schrmich/speedy_gonzales/Software/SpeedyBotV2/01 System/20180202_150233.jpg

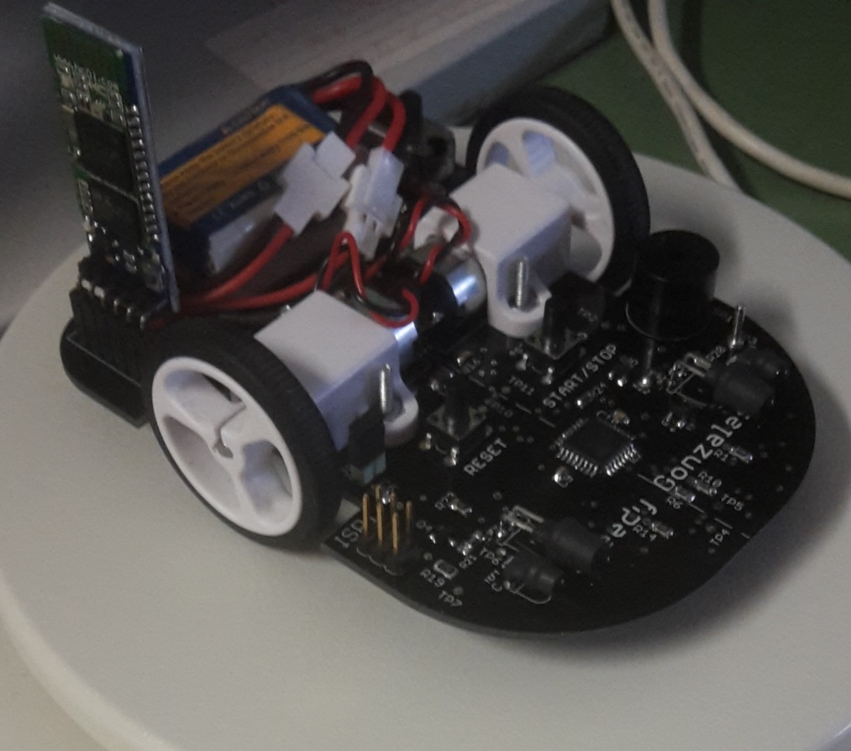
Software/SpeedyBotV2/01 System/20180202_150233.jpg
