schrmich/speedy_gonzales/Software/SpeedyBotV2/01 System/doxygen/latex/index.tex

$<$imga src=\char`\"{}/20180202\+\_\+150233.\+jpg\char`\"{} alt=\char`\"{}\+Speedy-\/bot\char`\"{}$>$

\begin{DoxyVersion}{Version}
V2 
\end{DoxyVersion}
\hypertarget{index_sec1}{}\doxysection{Einleitung}\label{index_sec1}
Der Roboter „\+Spirit bot“ ist ein kleiner frei in C programmierbarer Lern Roboter. Er soll in der Lage sein,~\newline
 verschiedene Aufgaben selbststaendig zu erledigen. Dazu gehoeren das Loesen von Linienlabyrinthen.~\newline

~\newline
\hypertarget{index_sec2_1}{}\doxysubsection{Hardware}\label{index_sec2_1}
Zur detektion von Linien ist er mit einer Reihe von 5 analogen I\+R-\/\+Reflektions Sensoren an der Unterseite ausgestattet.~\newline
 Als Antrieb dienen zwei D\+C-\/\+Getriebemotoren.~\newline
 Zwei optische Motorencoder dienen der Erfassung von zurück gelegter Entfernung.~\newline
 Zur Kommunikation wird ein H\+C-\/06 Bluetooth Modul mit 57200 Baud verwendet.~\newline
 Die Elektronik ist komplett in S\+MD aufgebaut und als Steuercomputer werkelt ein Atmega644\+PA.~\newline
\hypertarget{index_sec2_2}{}\doxysubsection{Verwendete Perepherie}\label{index_sec2_2}
\begin{DoxyAuthor}{Author}
Michael Schreiber 
\end{DoxyAuthor}
