schrmich/speedy_gonzales/Software/SpeedyBotV2/01 System/doxygen/latex/modules.tex

\doxysection{Modules}
Here is a list of all modules\+:\begin{DoxyCompactList}
\item \contentsline{section}{U\+A\+RT Library $<$uart.\+h$>$}{\pageref{group__pfleury__uart}}{}
\end{DoxyCompactList}
