schrmich/speedy_gonzales/Software/SpeedyBotV2/01 System/doxygen/latex/speedy_8h.tex

\hypertarget{speedy_8h}{}\doxysection{speedy.\+h File Reference}
\label{speedy_8h}\index{speedy.h@{speedy.h}}

Zugriff auf alle Funktionen von Speedy.  

{\ttfamily \#include \char`\"{}system.\+h\char`\"{}}\newline
{\ttfamily \#include \char`\"{}uart.\+h\char`\"{}}\newline
{\ttfamily \#include \char`\"{}timer.\+h\char`\"{}}\newline
{\ttfamily \#include \char`\"{}motor.\+h\char`\"{}}\newline
{\ttfamily \#include \char`\"{}line\+\_\+sensors.\+h\char`\"{}}\newline
{\ttfamily \#include \char`\"{}encoder.\+h\char`\"{}}\newline
{\ttfamily \#include \char`\"{}log.\+h\char`\"{}}\newline

\doxysubsection{Detailed Description}
Zugriff auf alle Funktionen von Speedy. 

Diese Datei muss uns Projekt als erstes ins Projekt includiert werden.~\newline
 In dieser Datei sind alle anderen Headerdateien der Library eingebunden.
