schrmich/speedy_gonzales/Software/SpeedyBotV2/01 System/doxygen/latex/uart_8h.tex

\hypertarget{uart_8h}{}\doxysection{uart.\+h File Reference}
\label{uart_8h}\index{uart.h@{uart.h}}
{\ttfamily \#include $<$avr/pgmspace.\+h$>$}\newline
\doxysubsection*{Macros}
\begin{DoxyCompactItemize}
\item 
\#define \mbox{\hyperlink{group__pfleury__uart_ga367ff7b5de225ed936a63239ad4adb0b}{U\+A\+R\+T\+\_\+\+B\+A\+U\+D\+\_\+\+S\+E\+L\+E\+CT}}(baud\+Rate,  xtal\+Cpu)~(((xtal\+Cpu) + 8UL $\ast$ (baud\+Rate)) / (16UL $\ast$ (baud\+Rate)) -\/1UL)
\begin{DoxyCompactList}\small\item\em U\+A\+RT Baudrate Expression. \end{DoxyCompactList}\item 
\#define \mbox{\hyperlink{group__pfleury__uart_ga1a02d45130520cb651ab313e69039382}{U\+A\+R\+T\+\_\+\+B\+A\+U\+D\+\_\+\+S\+E\+L\+E\+C\+T\+\_\+\+D\+O\+U\+B\+L\+E\+\_\+\+S\+P\+E\+ED}}(baud\+Rate,  xtal\+Cpu)~( ((((xtal\+Cpu) + 4UL $\ast$ (baud\+Rate)) / (8UL $\ast$ (baud\+Rate)) -\/1UL)) $\vert$ 0x8000)
\begin{DoxyCompactList}\small\item\em U\+A\+RT Baudrate Expression for A\+Tmega double speed mode. \end{DoxyCompactList}\item 
\#define \mbox{\hyperlink{group__pfleury__uart_ga5bdd6772c246436bb14377095de79b31}{U\+A\+R\+T\+\_\+\+R\+X\+\_\+\+B\+U\+F\+F\+E\+R\+\_\+\+S\+I\+ZE}}~32
\begin{DoxyCompactList}\small\item\em Size of the circular receive buffer, must be power of 2. \end{DoxyCompactList}\item 
\#define \mbox{\hyperlink{group__pfleury__uart_ga05f5d709605c6317c97e4974bec3402a}{U\+A\+R\+T\+\_\+\+T\+X\+\_\+\+B\+U\+F\+F\+E\+R\+\_\+\+S\+I\+ZE}}~32
\begin{DoxyCompactList}\small\item\em Size of the circular transmit buffer, must be power of 2. \end{DoxyCompactList}\item 
\#define \mbox{\hyperlink{group__pfleury__uart_gabcdb1041d763560cd8f8e722370dfd37}{U\+A\+R\+T\+\_\+\+F\+R\+A\+M\+E\+\_\+\+E\+R\+R\+OR}}~0x1000
\begin{DoxyCompactList}\small\item\em Framing Error by U\+A\+RT ~\newline
 \end{DoxyCompactList}\item 
\#define \mbox{\hyperlink{group__pfleury__uart_ga3183177e3613d8785d8cc8516931beb6}{U\+A\+R\+T\+\_\+\+O\+V\+E\+R\+R\+U\+N\+\_\+\+E\+R\+R\+OR}}~0x0800
\begin{DoxyCompactList}\small\item\em Overrun condition by U\+A\+RT ~\newline
 \end{DoxyCompactList}\item 
\#define \mbox{\hyperlink{group__pfleury__uart_ga946e3d317937e003d2057bf19e96dd1d}{U\+A\+R\+T\+\_\+\+P\+A\+R\+I\+T\+Y\+\_\+\+E\+R\+R\+OR}}~0x0400
\begin{DoxyCompactList}\small\item\em Parity Error by U\+A\+RT ~\newline
 \end{DoxyCompactList}\item 
\#define \mbox{\hyperlink{group__pfleury__uart_ga94758f3dad6864703b7417d3e40f11df}{U\+A\+R\+T\+\_\+\+B\+U\+F\+F\+E\+R\+\_\+\+O\+V\+E\+R\+F\+L\+OW}}~0x0200
\begin{DoxyCompactList}\small\item\em receive ringbuffer overflow \end{DoxyCompactList}\item 
\#define \mbox{\hyperlink{group__pfleury__uart_ga77ba544d423ff42d400220a05303f268}{U\+A\+R\+T\+\_\+\+N\+O\+\_\+\+D\+A\+TA}}~0x0100
\begin{DoxyCompactList}\small\item\em no receive data available ~\newline
 \end{DoxyCompactList}\item 
\#define \mbox{\hyperlink{group__pfleury__uart_gae9e143569df2285379bc55f9f5595bf9}{uart\+\_\+puts\+\_\+P}}(\+\_\+\+\_\+s)~\mbox{\hyperlink{group__pfleury__uart_ga6d78b6744db6232f52b4616402036c2f}{uart\+\_\+puts\+\_\+p}}(P\+S\+TR(\+\_\+\+\_\+s))
\begin{DoxyCompactList}\small\item\em Macro to automatically put a string constant into program memory. \end{DoxyCompactList}\item 
\#define \mbox{\hyperlink{group__pfleury__uart_gaabd7a5b0c15611ee9ecb2873cc9ee87a}{uart1\+\_\+puts\+\_\+P}}(\+\_\+\+\_\+s)~\mbox{\hyperlink{group__pfleury__uart_ga1e8074d0a2d5922601c5db2f9777ba79}{uart1\+\_\+puts\+\_\+p}}(P\+S\+TR(\+\_\+\+\_\+s))
\begin{DoxyCompactList}\small\item\em Macro to automatically put a string constant into program memory. \end{DoxyCompactList}\end{DoxyCompactItemize}
\doxysubsection*{Functions}
\begin{DoxyCompactItemize}
\item 
void \mbox{\hyperlink{group__pfleury__uart_gac19a76bb7d446125734a67f9f4b68991}{uart\+\_\+init}} (unsigned int baudrate)
\begin{DoxyCompactList}\small\item\em Initialize U\+A\+RT and set baudrate. \end{DoxyCompactList}\item 
unsigned int \mbox{\hyperlink{group__pfleury__uart_gaefaab30a8338ec46a6be35b99b1b4f09}{uart\+\_\+getc}} (void)
\begin{DoxyCompactList}\small\item\em Get received byte from ringbuffer. \end{DoxyCompactList}\item 
void \mbox{\hyperlink{group__pfleury__uart_gad975221bc08b901e4c7ad69f9c9a97e2}{uart\+\_\+putc}} (unsigned char data)
\begin{DoxyCompactList}\small\item\em Put byte to ringbuffer for transmitting via U\+A\+RT. \end{DoxyCompactList}\item 
void \mbox{\hyperlink{group__pfleury__uart_gae52facc0a56086a365bb0018160d8d71}{uart\+\_\+puts}} (const char $\ast$s)
\begin{DoxyCompactList}\small\item\em Put string to ringbuffer for transmitting via U\+A\+RT. \end{DoxyCompactList}\item 
void \mbox{\hyperlink{group__pfleury__uart_ga6d78b6744db6232f52b4616402036c2f}{uart\+\_\+puts\+\_\+p}} (const char $\ast$s)
\begin{DoxyCompactList}\small\item\em Put string from program memory to ringbuffer for transmitting via U\+A\+RT. \end{DoxyCompactList}\item 
void \mbox{\hyperlink{group__pfleury__uart_ga4db697cb5469fd70e794fa7df73a6d6a}{uart1\+\_\+init}} (unsigned int baudrate)
\begin{DoxyCompactList}\small\item\em Initialize U\+S\+A\+R\+T1 (only available on selected A\+Tmegas) \end{DoxyCompactList}\item 
unsigned int \mbox{\hyperlink{group__pfleury__uart_gaeb1405c641e5bc9b7224018f5e8d90de}{uart1\+\_\+getc}} (void)
\begin{DoxyCompactList}\small\item\em Get received byte of U\+S\+A\+R\+T1 from ringbuffer. (only available on selected A\+Tmega) \end{DoxyCompactList}\item 
void \mbox{\hyperlink{group__pfleury__uart_gab465f689d197fadfbacc374fc9411154}{uart1\+\_\+putc}} (unsigned char data)
\begin{DoxyCompactList}\small\item\em Put byte to ringbuffer for transmitting via U\+S\+A\+R\+T1 (only available on selected A\+Tmega) \end{DoxyCompactList}\item 
void \mbox{\hyperlink{group__pfleury__uart_ga5568f8f3913b218fd4d0346af78831b2}{uart1\+\_\+puts}} (const char $\ast$s)
\begin{DoxyCompactList}\small\item\em Put string to ringbuffer for transmitting via U\+S\+A\+R\+T1 (only available on selected A\+Tmega) \end{DoxyCompactList}\item 
void \mbox{\hyperlink{group__pfleury__uart_ga1e8074d0a2d5922601c5db2f9777ba79}{uart1\+\_\+puts\+\_\+p}} (const char $\ast$s)
\begin{DoxyCompactList}\small\item\em Put string from program memory to ringbuffer for transmitting via U\+S\+A\+R\+T1 (only available on selected A\+Tmega) \end{DoxyCompactList}\end{DoxyCompactItemize}
