schrmich/speedy_gonzales/Doku/Rechnung JLCPCB 15.04.2020.pdf

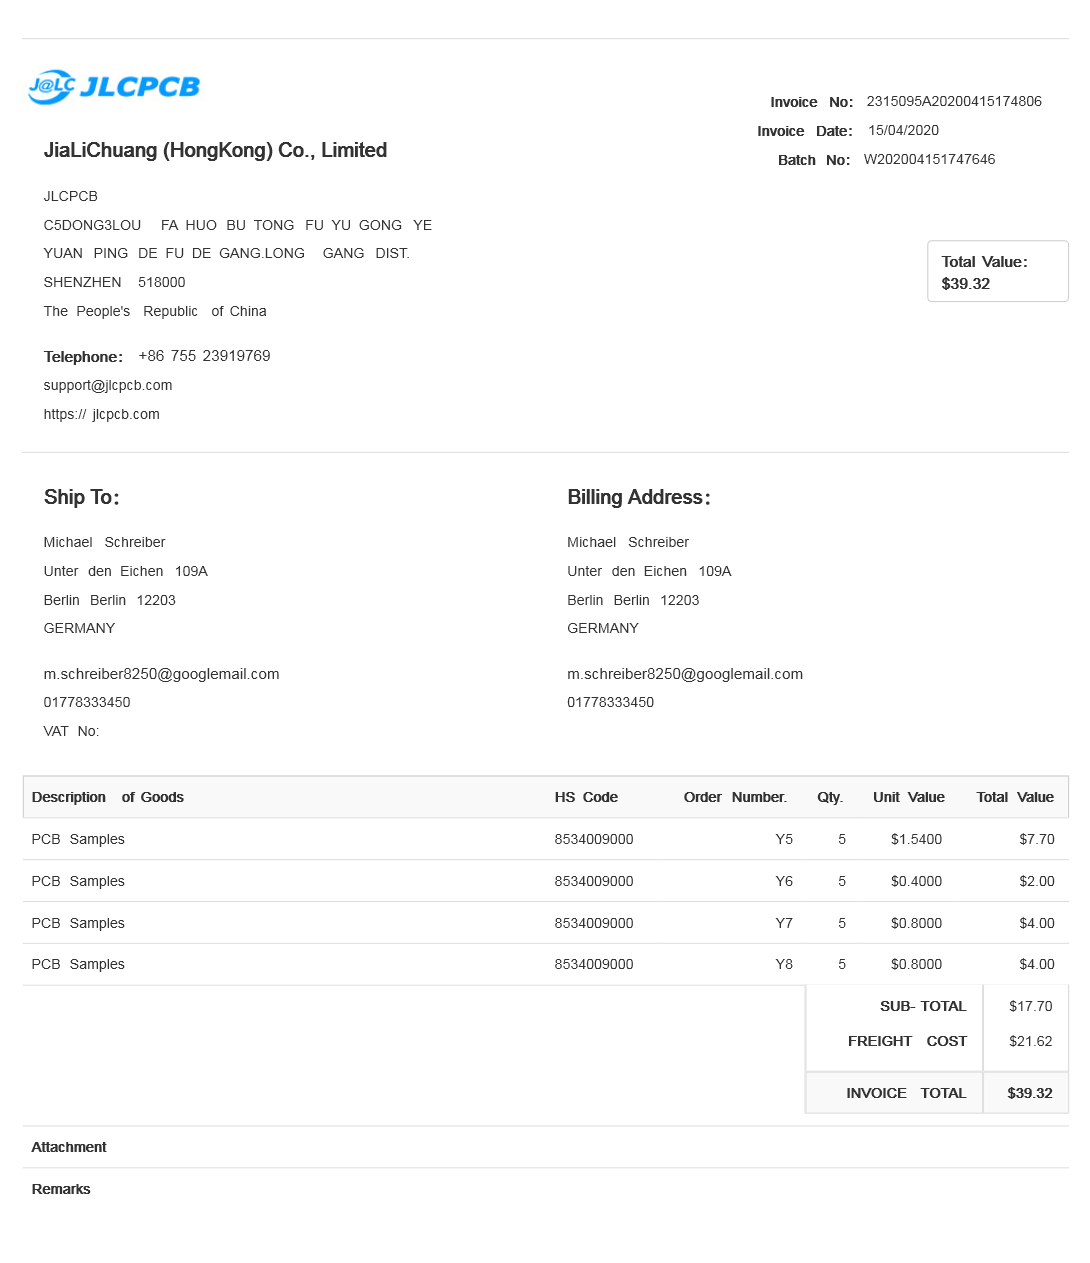
[picture p2: page 1]
