schrmich/speedy_gonzales/Doku/ascii-tabelle.gif

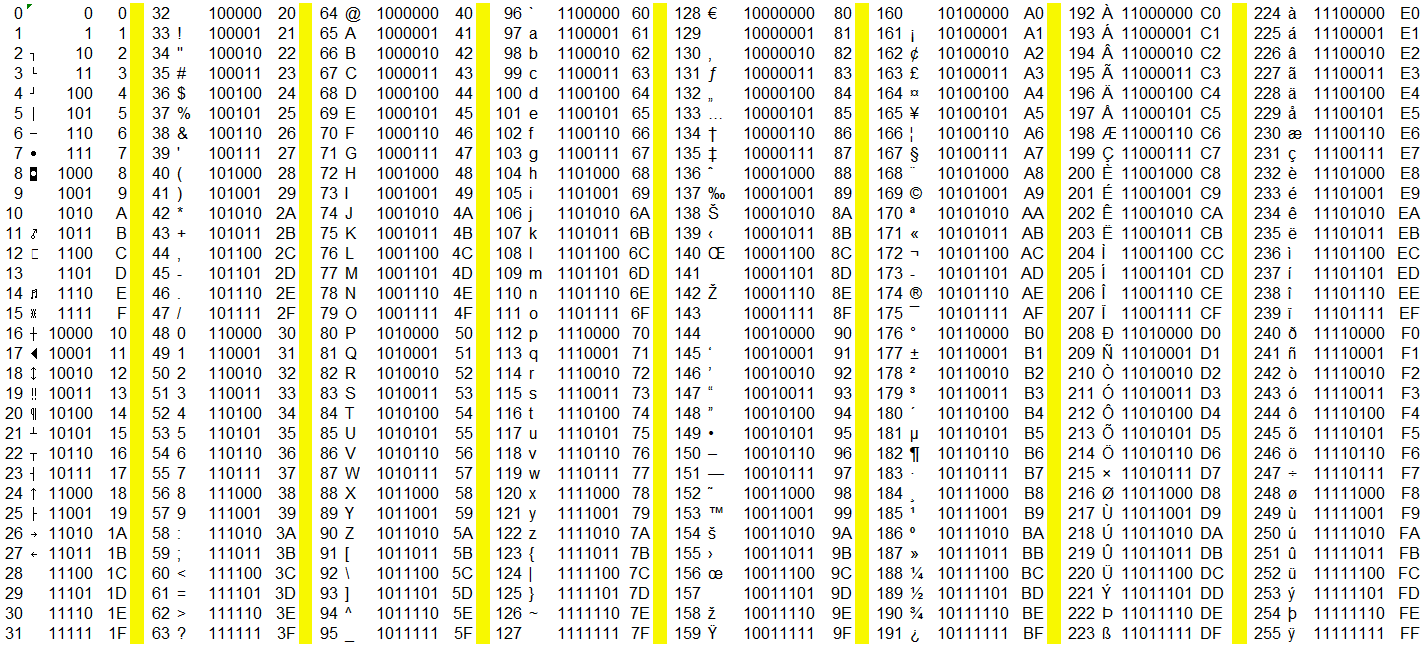
Doku/ascii-tabelle.gif
