schrmich/speedy_gonzales/Doku/Encoder/Encoder.bmp

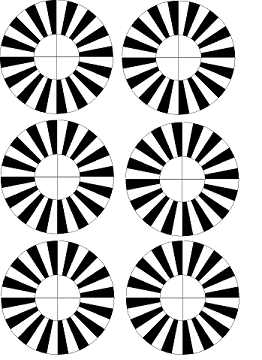
Doku/Encoder/Encoder.bmp
