schrmich/speedy_gonzales/Doku/Encoder/Encoder_slice.png

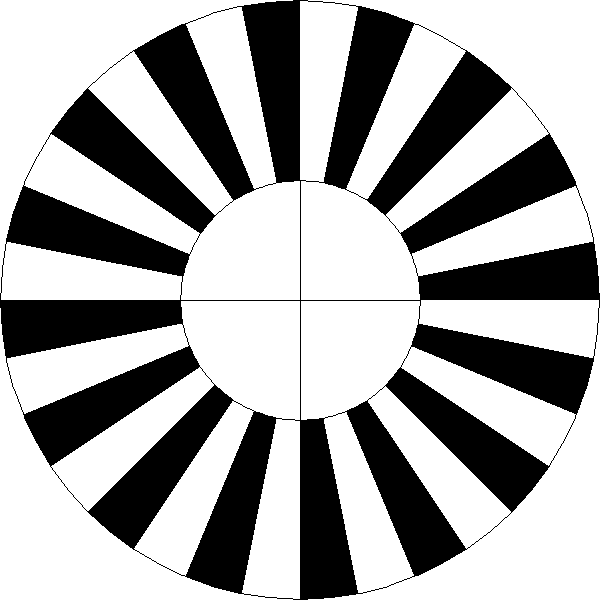
Doku/Encoder/Encoder_slice.png
