schrmich/speedy_gonzales/Doku/Encoder/SCR02.PNG

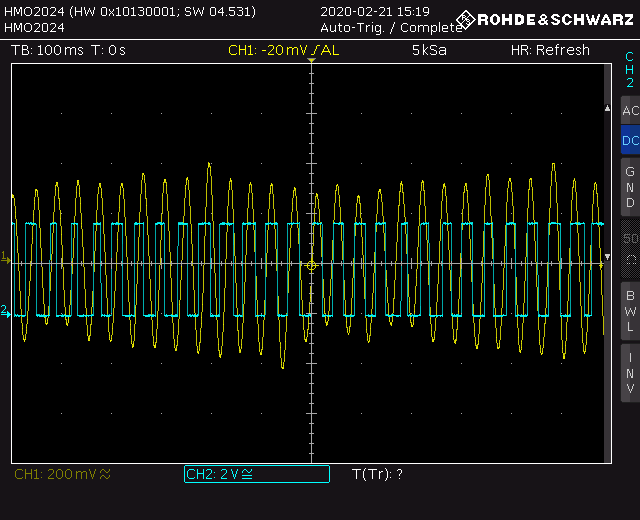
Doku/Encoder/SCR02.PNG
