schrmich/speedy_gonzales/Doku/Encoder/SCR03.PNG

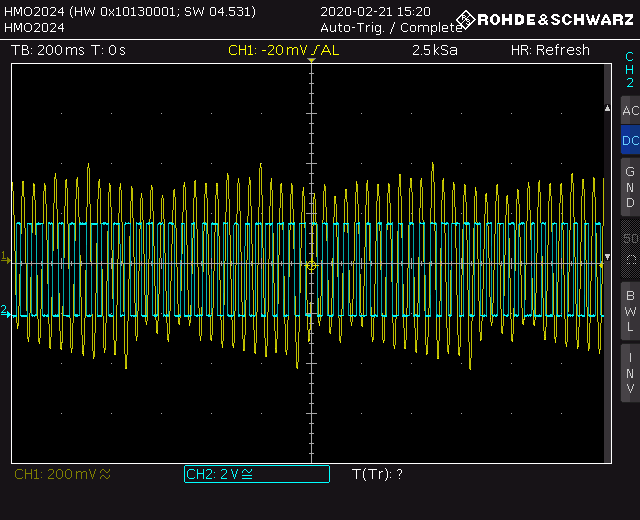
Doku/Encoder/SCR03.PNG
