schrmich/speedy_gonzales/Doku/Encoder/SCR04.PNG

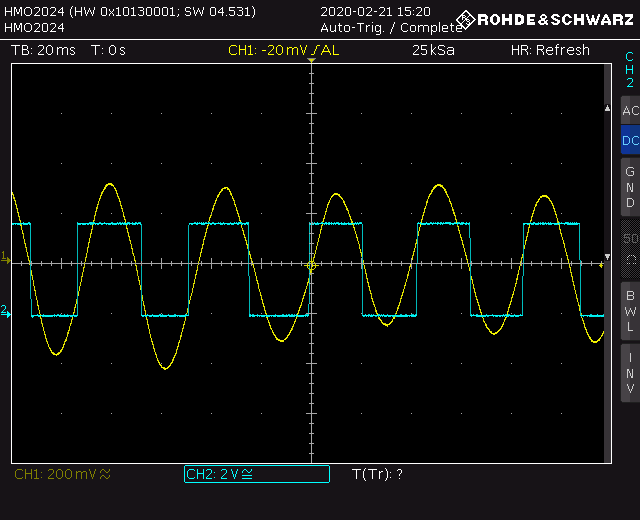
Doku/Encoder/SCR04.PNG
