schrmich/speedy_gonzales/Doku/Linien/Linienkurs#1.png

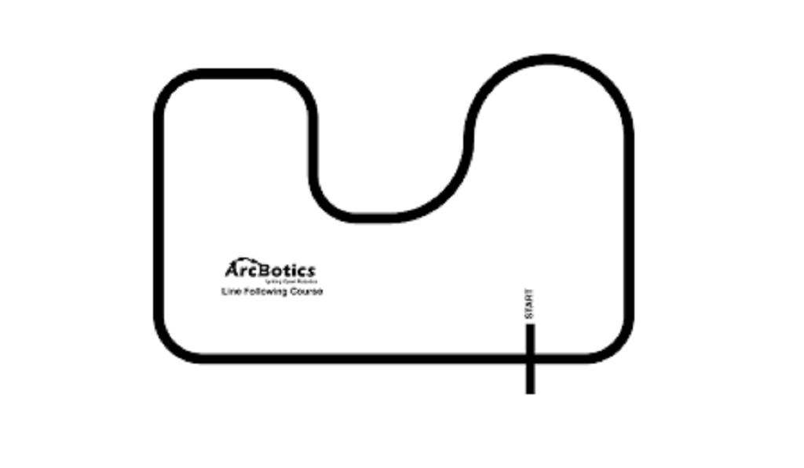
Doku/Linien/Linienkurs#1.png
