schrmich/speedy_gonzales/Doku/Maze Solver Flowcharts/Maze Search I State-Machine.png

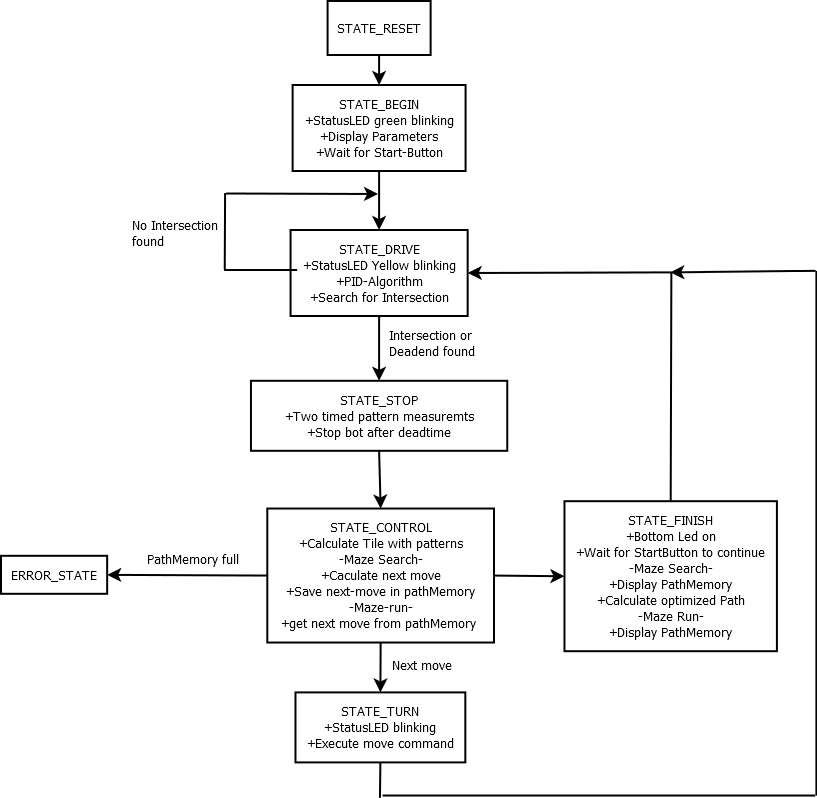
Doku/Maze Solver Flowcharts/Maze Search I State-Machine.png
