schrmich/speedy_gonzales/Doku/Maze Solver Flowcharts/Maze Search II.png

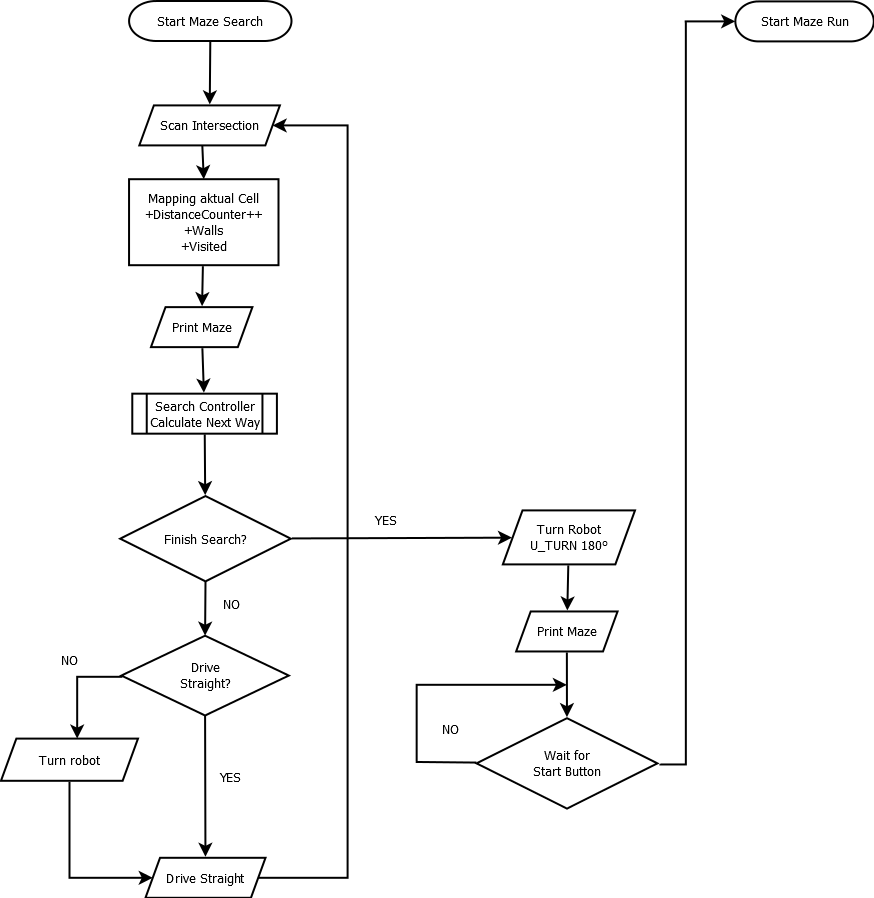
Doku/Maze Solver Flowcharts/Maze Search II.png
