schrmich/speedy_gonzales/Doku/Maze Solver Flowcharts/Maze solver II.png

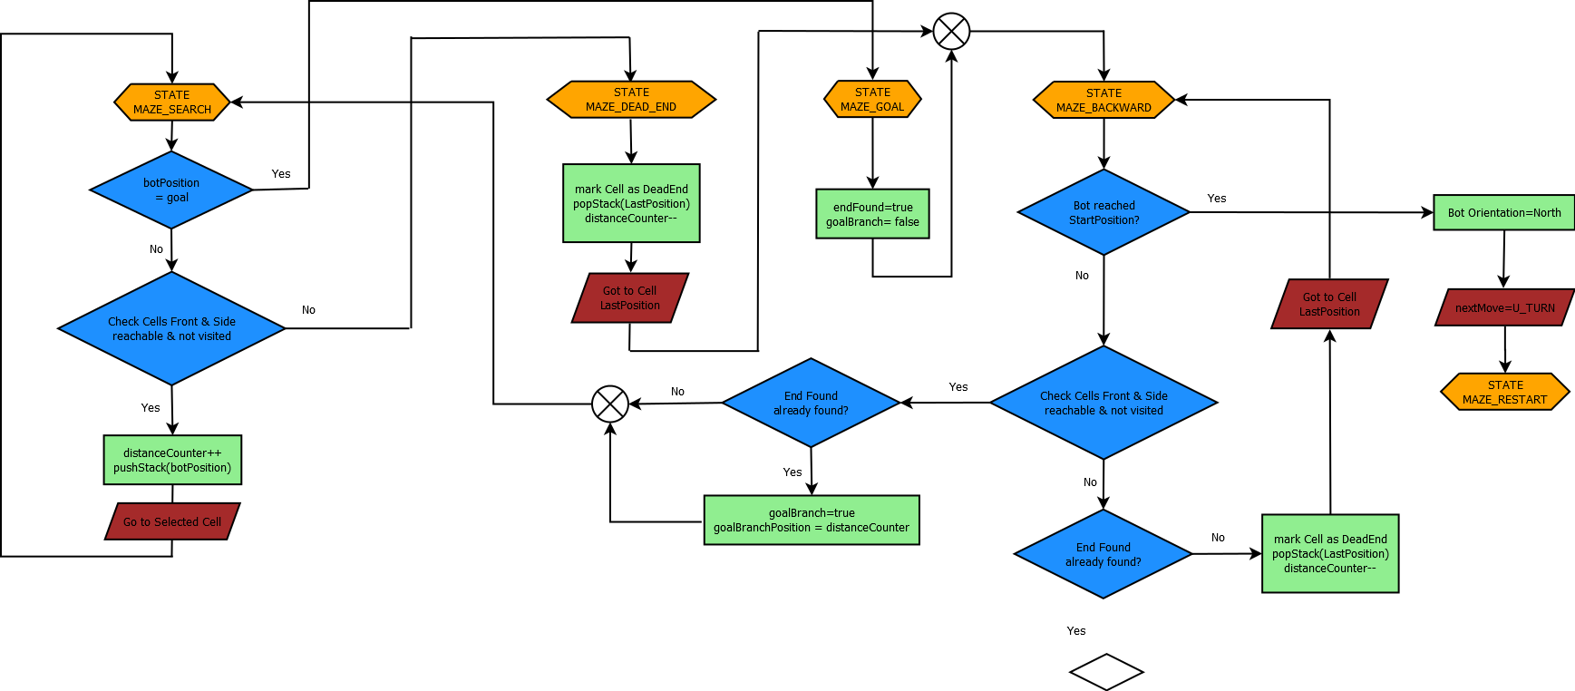
Doku/Maze Solver Flowcharts/Maze solver II.png
