schrmich/speedy_gonzales/Doku/Speedy Blockdiagramm.png

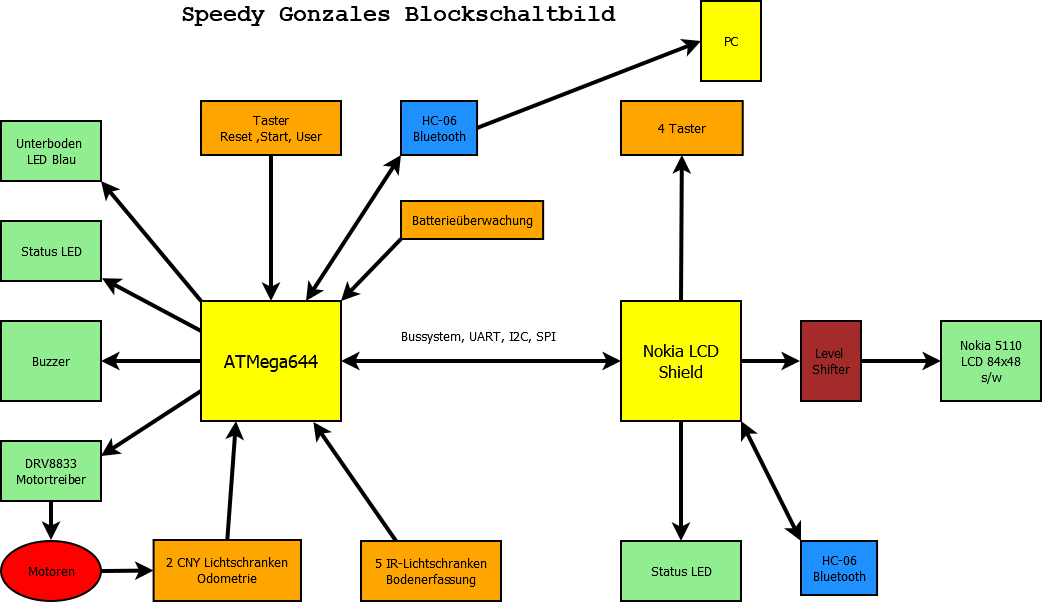
Doku/Speedy Blockdiagramm.png
