schrmich/speedy_gonzales/Hardware/Mechanik/Motor + Encoder.jpg

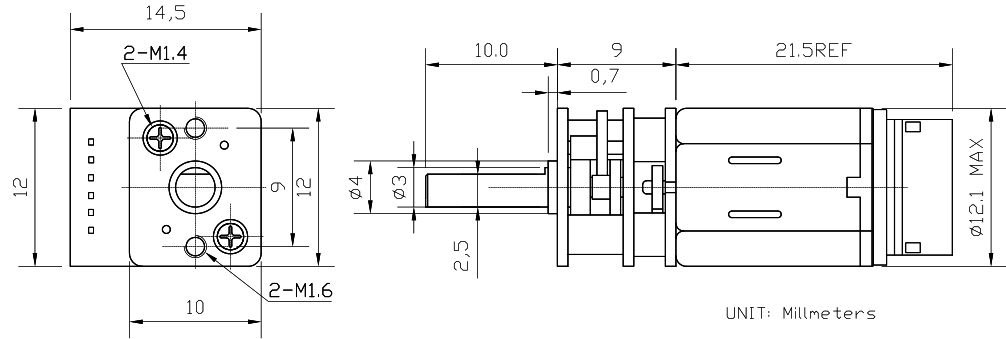
Hardware/Mechanik/Motor + Encoder.jpg
