schrmich/speedy_gonzales/Hardware/Mechanik/Motor.jpg

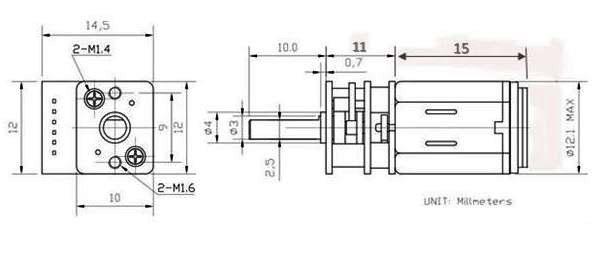
Hardware/Mechanik/Motor.jpg
