schrmich/speedy_gonzales/Hardware/Mechanik/pololu-micro-metal-gearmotor-bracket-extended-pair~2.jpg

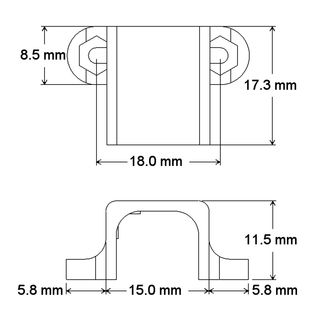
Hardware/Mechanik/pololu-micro-metal-gearmotor-bracket-extended-pair~2.jpg
