schrmich/speedy_gonzales/Hardware/Mechanik/Wheel 32x7mm.jpg

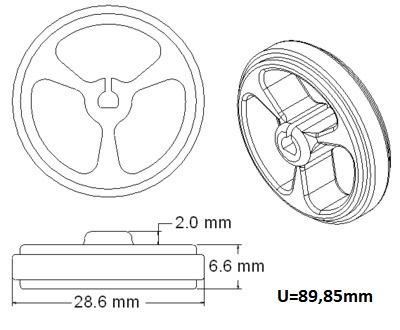
Hardware/Mechanik/Wheel 32x7mm.jpg
