schrmich/speedy_gonzales/Hardware/BOM Speedy V2.xlsx

Qty | Value | Device | Package | Parts | Description | Händler | Artikel Nr. | Preis | Gesamt | Lager
2 |  | SJ | SJ | SJ1, SJ2 | SMD solder JUMPER | - |  |  | 0.00 €
1 | HC-06 | HC-06 | BT_BOARD | U1 |  | ebay |  | 5.80 € | 5.80 €
1 | Pair Motor brackets extended | Pair Motor brackets extended | FUTURA_V1.0_MOTOT_MOUNT | M1, M0 | Motor Halterungen | Eckstein |  | 7.95 € | 7.95 €
1 | pair wheels 32x7mm | pair wheels 32x7mm | Wheels 32x7 | M1, M1 | Räder | Eckstein |  | 4.98 € | 4.98 €
2 | Pololu Micro Metal Gearmotor | Pololu 100:1 Micro Metal Gearmotor HPCB 6V 330RPM | Pololu 100:1 Micro Metal Gearmotor HPCB 6V 330RPM | M1, M2 | Getriebemotor 6V, 330 u/min, 1:100 Untersetzung | Eckstein |  | 17.95 € | 35.90 €
2 | Ball roller |  |  |  | Stützräder | Eckstein
5 | QRE1113 | QRE1113 | QRE1113 | IC3, IC4, IC5, IC6, IC7 | Reflexlichtschranke, Gullwings | Farnell | 1471020 | 0.51 € | 2.55 € | 1
3 | KMR211G_SWITCH | KMR211G_SWITCH | KMR211G_SWITCH | SW1, SW2, SW3 | Miniaturschalter | Farnell | 1437635 | 0.40 € | 1.20 € | 7
1 | DRV8833 | DRV8833 | SOP65P640X120-17N | U2 | Dual Motor Controller | Farnell | 2450164 | 1.75 € | 1.75 € | 1
2 | 22k | R-TRIMM3214W | RTRIM3214W | R35, R36 | Trimm resistor | FU |  | 2.00 € | 4.00 € | 2
1 | ATMEGA644A | ATMEGA644A | TQFP44 | IC2 | 8-bit Microcontroller with 64K Bytes In-System Programmable Flash | Home |  | 3.50 € | 3.50 € | 3
2 |  | FE08-1 | FE08 | BUS1, BUS2 | FEMALE HEADER | Reichelt |  | 0.23 € | 0.46 €
1 | 100µF | CPOL-EUD | PANASONIC_D | C1 | POLARIZED CAPACITOR, European symbol | Reichelt |  | 0.18 € | 0.18 € | 1
3 | 100nF | C-EUC0603 | C0603 | C10, C11, C12 | CAPACITOR, European symbol | Reichelt |  | 0.02 € | 0.06 €
1 | 10µF | C-EUC1206 | C1206 | C13 | CAPACITOR, European symbol | Reichelt |  | 0.30 € | 0.30 € | 6
1 | 10nF | C-EUC0805 | C0805 | C15 | CAPACITOR, European symbol | Reichelt |  | 0.02 € | 0.02 €
1 | 2,2µF | C-EUC1206 | C1206 | C16 | CAPACITOR, European symbol | Reichelt |  | 0.02 € | 0.02 €
7 | 100nF | C-EUC0805 | C0805 | C2, C3, C5, C6, C17, C18 | CAPACITOR, European symbol | Reichelt |  | 0.04 € | 0.28 € | 5
1 | 22µF | CPOL-EUB | PANASONIC_B | C4 | POLARIZED CAPACITOR, European symbol | Reichelt |  | 0.14 € | 0.14 €
2 | 22p | C-EUC0603 | C0603 | C7, C8 | CAPACITOR, European symbol | Reichelt |  | 0.02 € | 0.04 € | 4
1 | 10nF | C-EUC0603 | C0603 | C9 | CAPACITOR, European symbol | Reichelt |  | 0.02 € | 0.02 € | 1
1 | MBRA340T3 | MBRA340T3 | SMA | D1 | Surface Mount Schottky Power Rectifier | Reichelt |  | 0.21 € | 0.21 €
1 | REG1117 | REG1117 | SOT223 | IC1 | 800mA and 1A Low Dropout (LDO) Positive Regulator | Reichelt |  | 0.29 € | 0.29 € | 1
1 | 74HC08D | 74HC08D | SO14 | IC8 | Quad 2-input AND gate | Reichelt |  | 0.18 € | 0.18 €
1 | LM358D | LM358D | SO08 | IC9 | OP AMP also LM158; LM258; LM2904 | Reichelt |  | 0.15 € | 0.15 €
2 | CNY70_ENC | CNY70_ENC | CNY70_ENC | IC9, IC10 |  | Reichelt |  | 0.75 € | 1.50 €
1 | AVRISP-6 | AVRISP-6 | AVRISP | ISP1 | AVR ISP HEADER | Reichelt |  | 0.20 € | 0.20 €
1 | 10µH | L-1210 | C1210K | L1 | Drossel | Reichelt |  | 0.15 € | 0.15 € | 1
4 | bl | LEDCHIPLED_0805 | CHIPLED_0805 | LED1, LED2, LED3, LED4 | LED | Reichelt |  | 0.18 € | 0.72 € | 4
1 | LSG-T676 | LSG-T676 | P-LCC4-0 | LED5 | LSG T676 Hyper Multi TOPLED ® Hyper-Bright LED | Reichelt |  | 0.19 € | 0.19 €
1 | rt | LEDCHIP-LED0805 | CHIP-LED0805 | MOT_FLT | LED | Reichelt |  | 0.05 € | 0.05 € | 1
1 | gn | LEDCHIPLED_0805 | CHIPLED_0805 | PWR | LED | Reichelt |  | 0.05 € | 0.05 € | 1
3 | IRLML2030TRPbF | BSS123 | SOT23 | Q1, Q3, Q5 | N-CHANNEL MOS FET | Reichelt |  | 0.14 € | 0.42 € | 5
1 | 7X5MMMQ | 7X5MMMQ | 7X5MMQUARZ | Q2 | 16MHz Quarz | Reichelt |  | 0.90 € | 0.90 €
2 | FDV304P | FDV304P | SOT23 | Q4, Q6 | P-Channel Mosfet | Reichelt |  | 0.06 € | 0.12 €
2 | 100 | R-EU_R0805 | R0805 | R1, R2 | RESISTOR, European symbol | Reichelt |  | 0.02 € | 0.04 €
4 | 4,7k | R-EU_R0805 | R0805 | R10, R11, R32, R34 | RESISTOR, European symbol | Reichelt |  | 0.02 € | 0.08 € | 2
1 | 1k | R-EU_R0805 | R0805 | R14 | RESISTOR, European symbol | Reichelt |  | 0.02 € | 0.02 € | 1
1 | 2k | R-EU_R0805 | R0805 | R15 | RESISTOR, European symbol | Reichelt |  | 0.02 € | 0.02 € | 1
5 | 220R | R-EU_R0805 | R0805 | R17, R19, R21, R23, R25 | RESISTOR, European symbol | Reichelt |  | 0.02 € | 0.10 € | 5
1 | 620 | R-EU_R0805 | R0805 | R29 | RESISTOR, European symbol | Reichelt |  | 0.02 € | 0.02 €
2 | 51k | R-EU_R0805 | R0805 | R3, R5 | RESISTOR, European symbol | Reichelt |  | 0.02 € | 0.04 € | 2
2 | 180 | R-EU_R0805 | R0805 | R31, R33 | RESISTOR, European symbol | Reichelt |  | 0.02 € | 0.04 €
1 | 560 | R-EU_R0805 | R0805 | R4 | RESISTOR, European symbol | Reichelt |  | 0.02 € | 0.02 € | 2
10 | 47k | R-EU_R0805 | R0805 | R6, R12, R13, R16, R18, R20, R22, R24, R26, R30 | RESISTOR, European symbol | Reichelt |  | 0.02 € | 0.20 € | 5
3 | 22k | R-EU_R0805 | R0805 | R7, R27, R28 | RESISTOR, European symbol | Reichelt |  | 0.02 € | 0.06 €
2 | 470 | R-EU_R0805 | R0805 | R8, R9 | RESISTOR, European symbol | Reichelt |  | 0.02 € | 0.04 €
1 |  | MPF 120 | MPF 120 | S1 | SLIDING SWITCH | Reichelt |  | 0.90 € | 0.90 € | 2
1 | AL-60P12 | KSS1201 | KSS1201 | SP1 | SPEAKER | Reichelt |  |  | 0.00 € | 1
2 | JST XH2P ST | JST XH2P ST | JST XH2P ST | X1, X2 | JST XH Connector 2 Pin | Reichelt |  | 0.08 € | 0.16 € | 4
2 | JST XH2P BU | JST XH2P BU | JST XH2P BU | X1, X2 | JST XH Connector 2 Buchse | Reichelt |  | 0.04 € | 0.08 € | 4
5 | JST XH CKB | JST XH CKB | JST XH CKB | X1, X2 | JST XH Crimp Kontakt | Reichelt |  | 0.03 € | 0.15 € | 8
 |  |  |  |  |  |  |  |  | 76.25 €
