schrmich/speedy_gonzales/Hardware/Speedy V2 BOM.xlsx

Qty | Value | Device | Package | Parts | Description
2 |  | FE08-1 | FE08 | BUS1, BUS2 | FEMALE HEADER
2 | 100µF | CPOL-EUD | PANASONIC_D | C1, C19 | POLARIZED CAPACITOR, European symbol
3 | 100nF | C-EUC0603 | C0603 | C10, C11, C12 | CAPACITOR, European symbol
1 | 10µF | C-EUC1206 | C1206 | C13 | CAPACITOR, European symbol
1 | 100n | C-EUC0805 | C0805 | C14 | CAPACITOR, European symbol
1 | 10nF | C-EUC0805 | C0805 | C15 | CAPACITOR, European symbol
1 | 2,2µF | C-EUC1206 | C1206 | C16 | CAPACITOR, European symbol
7 | 100nF | C-EUC0805 | C0805 | C2, C3, C5, C6, C17, C18, C20 | CAPACITOR, European symbol
1 | 22µF | CPOL-EUB | PANASONIC_B | C4 | POLARIZED CAPACITOR, European symbol
2 | 22p | C-EUC0603 | C0603 | C7, C8 | CAPACITOR, European symbol
1 | 10nF | C-EUC0603 | C0603 | C9 | CAPACITOR, European symbol
2 | REG1117 | REG1117 | SOT223 | IC1, IC12 | 800mA and 1A Low Dropout (LDO) Positive Regulator
1 | LM358D | LM358D | SO08 | IC11 | OP AMP also LM158; LM258; LM2904
1 | ATMEGA644A | ATMEGA644A | TQFP44 | IC2 | 8-bit Microcontroller with 64K Bytes In-System Programmable Flash
5 | QRE1113 | QRE1113 | QRE1113 | IC3, IC4, IC5, IC6, IC7
1 | 74HC08D | 74HC08D | SO14 | IC8 | Quad 2-input AND gate
2 | CNY70_ENC | CNY70_ENC | CNY70_ENC | IC9, IC10
1 | AVRISP-6 | AVRISP-6 | AVRISP | ISP | AVR ISP HEADER
1 |  | PINHD-1X2 | 1X02 | JP1 | PIN HEADER
1 | 10µH | L-1210 | C1210K | L1
4 | bl | LEDCHIPLED_0805 | CHIPLED_0805 | LED1, LED2, LED3, LED4 | LED
1 | LSG-T676 | LSG-T676 | P-LCC4-0 | LED5 | LSG T676 Hyper Multi TOPLED ® Hyper-Bright LED
1 | rt | LEDCHIP-LED0805 | CHIP-LED0805 | MOT_FLT | LED
1 | gn | LEDCHIPLED_0805 | CHIPLED_0805 | PWR | LED
3 | IRLML2030TRPbF | BSS123 | SOT23 | Q1, Q3, Q5 | N-CHANNEL MOS FET
1 | 16MHz | 7X5MMMQ | 7X5MMQUARZ | Q2
2 | FDV304P | FDV304P | SOT23 | Q4, Q6
2 | 100 | R-EU_R0805 | R0805 | R1, R2 | RESISTOR, European symbol
4 | 4,7k | R-EU_R0805 | R0805 | R10, R11, R32, R34 | RESISTOR, European symbol
1 | 1k | R-EU_R0805 | R0805 | R14 | RESISTOR, European symbol
1 | 2k | R-EU_R0805 | R0805 | R15 | RESISTOR, European symbol
5 | 220R | R-EU_R0805 | R0805 | R17, R19, R21, R23, R25 | RESISTOR, European symbol
1 | 620 | R-EU_R0805 | R0805 | R29 | RESISTOR, European symbol
2 | 51k | R-EU_R0805 | R0805 | R3, R5 | RESISTOR, European symbol
2 | 180 | R-EU_R0805 | R0805 | R31, R33 | RESISTOR, European symbol
2 | 20k | R-TRIMM3314G | RTRIM3314G | R35, R36 | Trimm resistor
1 | 2,2k | R-EU_R0805 | R0805 | R37 | RESISTOR, European symbol
1 | 10k | R-TRIMM3314G | RTRIM3314G | R38 | Trimm resistor
1 | 560 | R-EU_R0805 | R0805 | R4 | RESISTOR, European symbol
10 | 47k | R-EU_R0805 | R0805 | R6, R12, R13, R16, R18, R20, R22, R24, R26, R30 | RESISTOR, European symbol
3 | 22k | R-EU_R0805 | R0805 | R7, R27, R28 | RESISTOR, European symbol
2 | 470 | R-EU_R0805 | R0805 | R8, R9 | RESISTOR, European symbol
1 | MPF 120 | 255SB | 255SB | S1 | SLIDING SWITCH
2 |  | SJ | SJ | SJ1, SJ2 | SMD solder JUMPER
1 | AL-60P12 | KSS1201 | KSS1201 | SP1 | SPEAKER
3 | KMR211G_SWITCH | KMR211G_SWITCH | KMR211G_SWITCH | SW1, SW2, SW3
4 | PTR1B1,27 | PTR1B1,27 | B1,27 | TP1, TP3, TP4, TP5 | TEST PIN
1 | PTR1PAD1-13 | PTR1PAD1-13 | P1-13 | TP2 | TEST PIN
1 | BT_BOARD | BT_BOARD | BT_BOARD | U1
1 | FUTURA_V1.0_MOTOR_MOUNT | FUTURA_V1.0_MOTOR_MOUNT | FUTURA_V1.0_MOTOT_MOUNT | U2
1 |  | DRV8833 | SOP65P640X120-17N | U3
2 | JST-XH-02-PIN-LONG-PAD | JST-XH-02-PIN-LONG-PAD | JST-XH-02-PACKAGE-LONG-PAD | X1, X2 | JST XH Connector 2 Pin
