schrmich/speedy_gonzales/Hardware/Bestückung_BOTTOM_V2.pdf

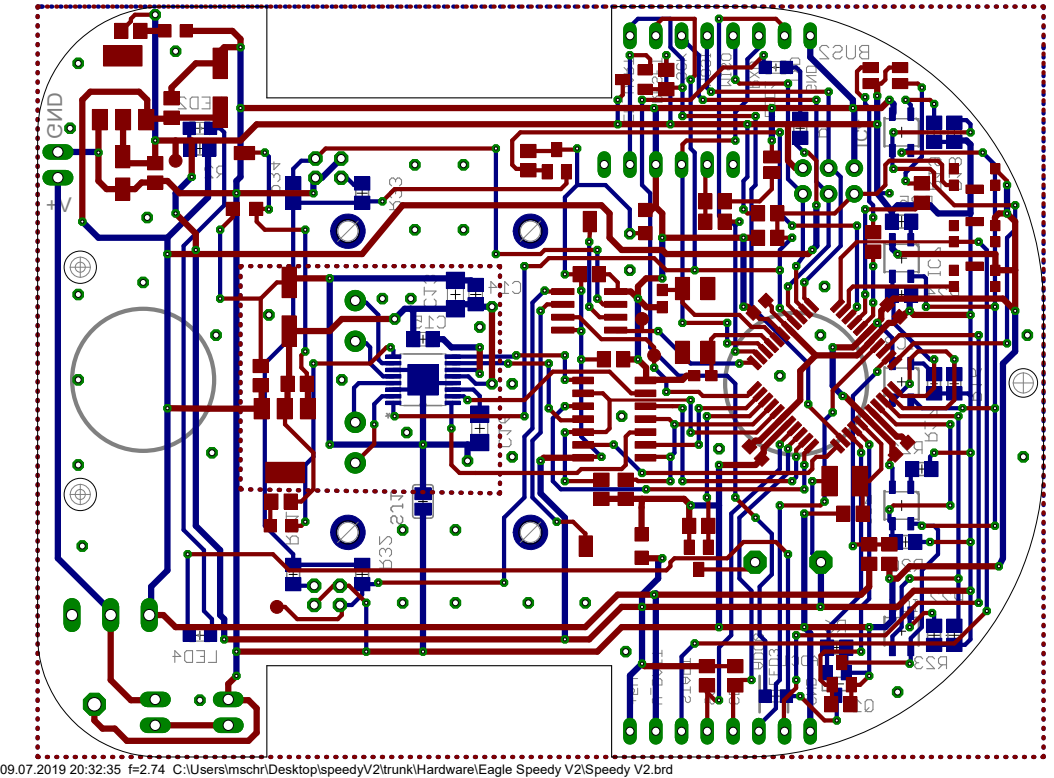
[picture p18: page 1]
* GND

09.07.2019 20:32:35 f=2.74 C:\Users\mschr\Desktop\speedyV2\trunk\Hardware\Eagle Speedy V2\Speedy V2.brd
