schrmich/speedy_gonzales/Hardware/SchaltplanV2.pdf

5V Power Supply | Blue Ground

A

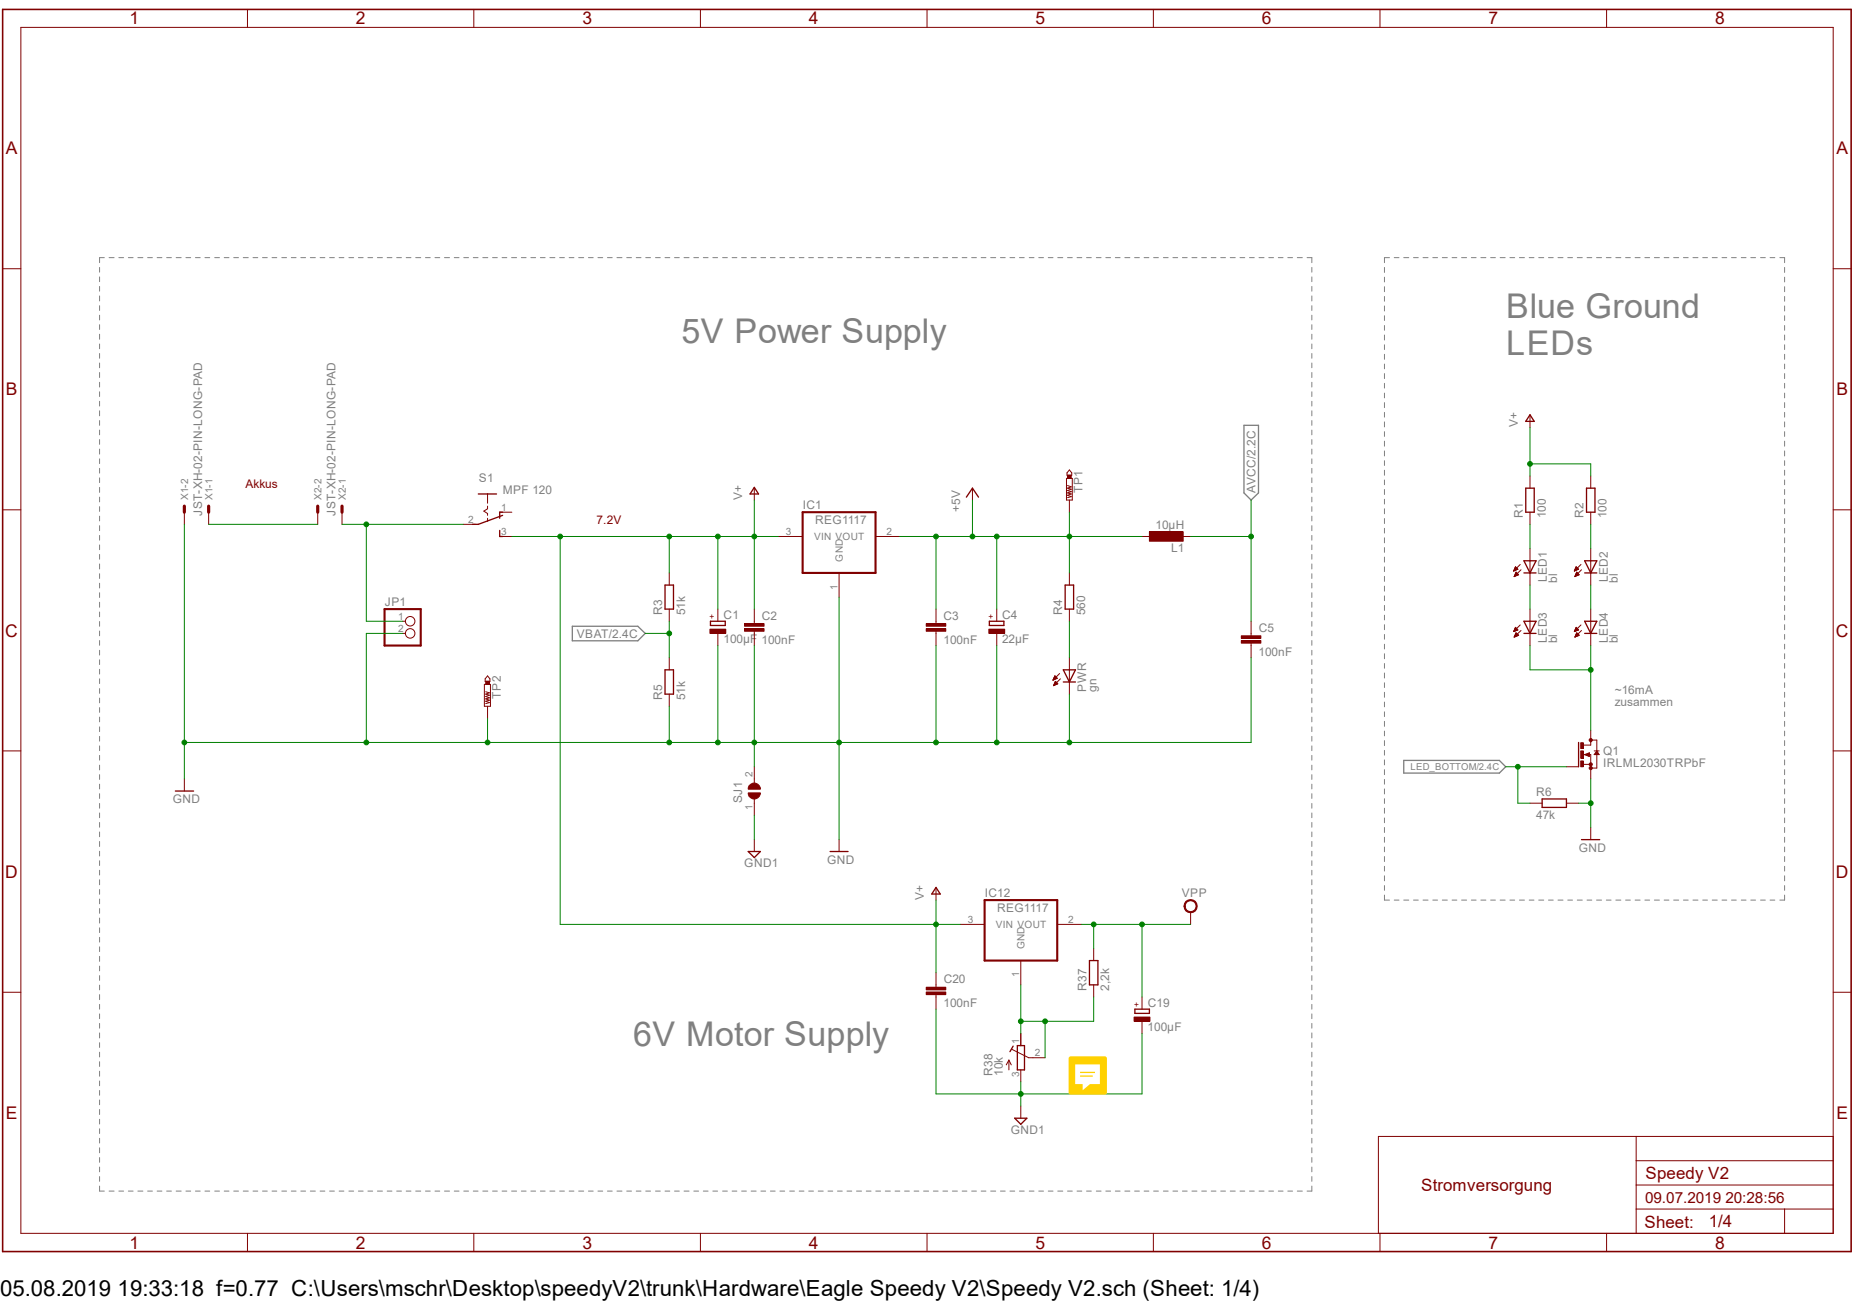
[picture p19: page 1]

Stromversorgung

Sheet: 1/4

05.08.2019 19:33:18 f=0.77 C:\Users\mschr\Desktop\speedyV2\trunk\Hardware\Eagle Speedy V2\Speedy V2.sch (Sheet: 1/4)

Start/Stop | Serial Interface HC⁻⁰⁶ Bluetooth Modul ATMega644P TQFP
GND ⁴,7k | 4,7k +5V | V⁺

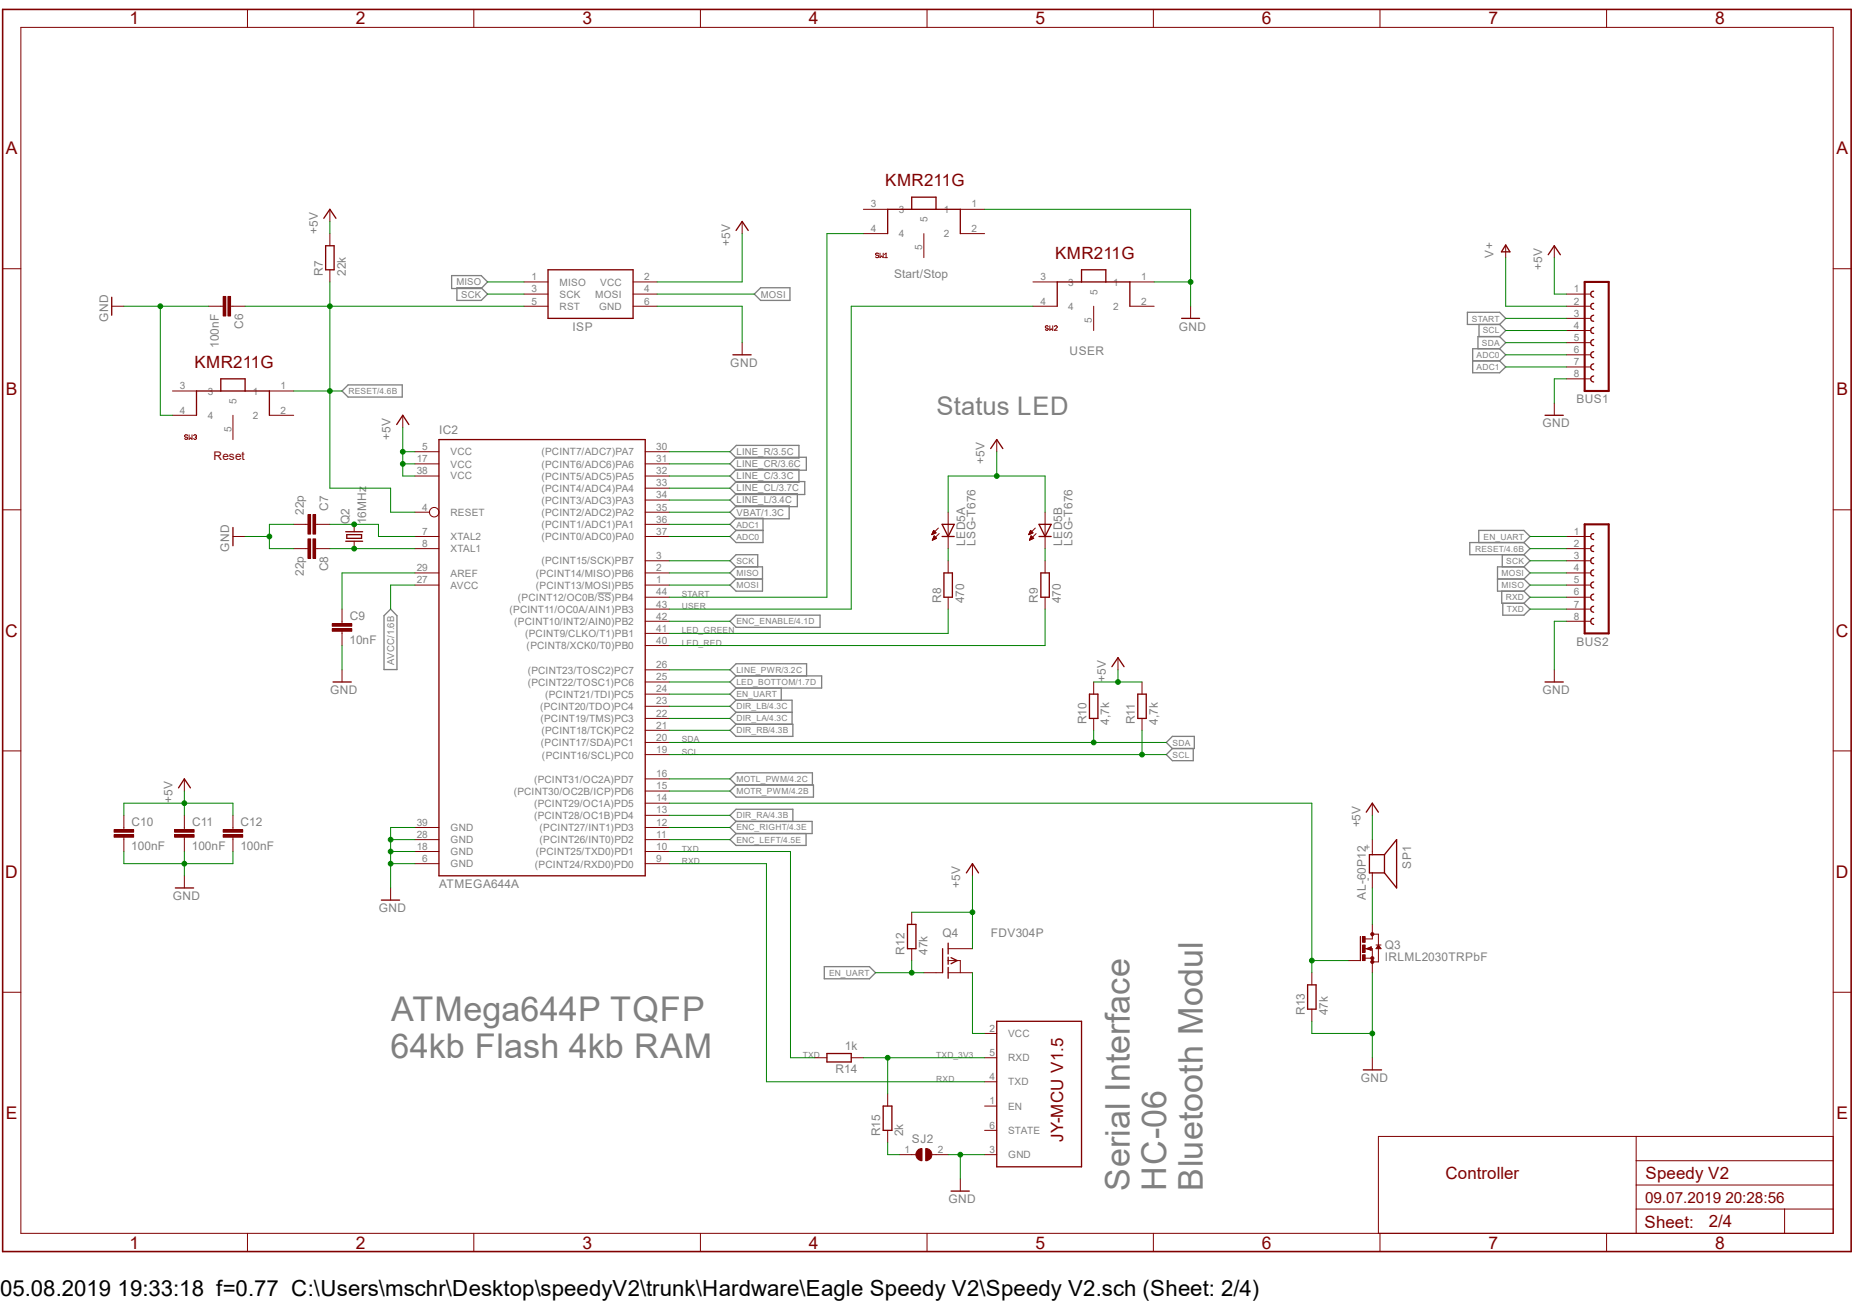
[picture p20: page 2]

Controller

Sheet: 2/4

05.08.2019 19:33:18 f=0.77 C:\Users\mschr\Desktop\speedyV2\trunk\Hardware\Eagle Speedy V2\Speedy V2.sch (Sheet: 2/4)

A

A

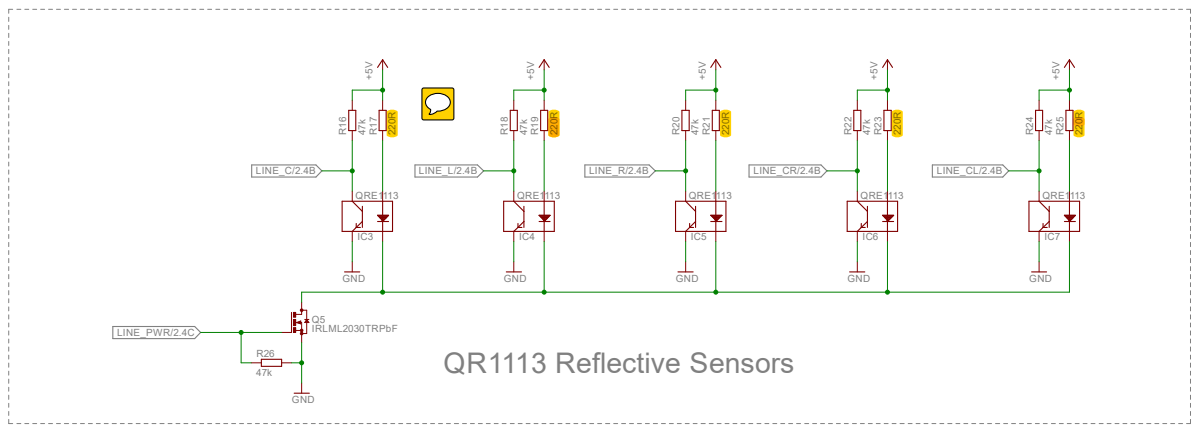
[picture p21: page 3]
QR1113 Reflective Sensors; QRE1113; QRE1113 QRE1113; QRE1113 ²²⁰R ⁺⁵V 47k; IRLML2030TRPbF; GND; IC6 R¹⁶; R¹⁷; R¹⁸; R¹⁹; R²⁰; R²¹; R²²; R²³; R²⁴; R²⁵; LINE_C/2.4B; LINE_L/2.4B; LINE_R/2.4B; LINE_CL/2.4B; LINE_PWR/2.4C; LINE_CR/2.4B; Sensoren; Speedy V2; Sheet: 3/4

05.08.2019 19:33:18 f=0.77 C:\Users\mschr\Desktop\speedyV2\trunk\Hardware\Eagle Speedy V2\Speedy V2.sch (Sheet: 3/4)

# DRV8833PWPR Motor Controller

# 100n 22k 22k

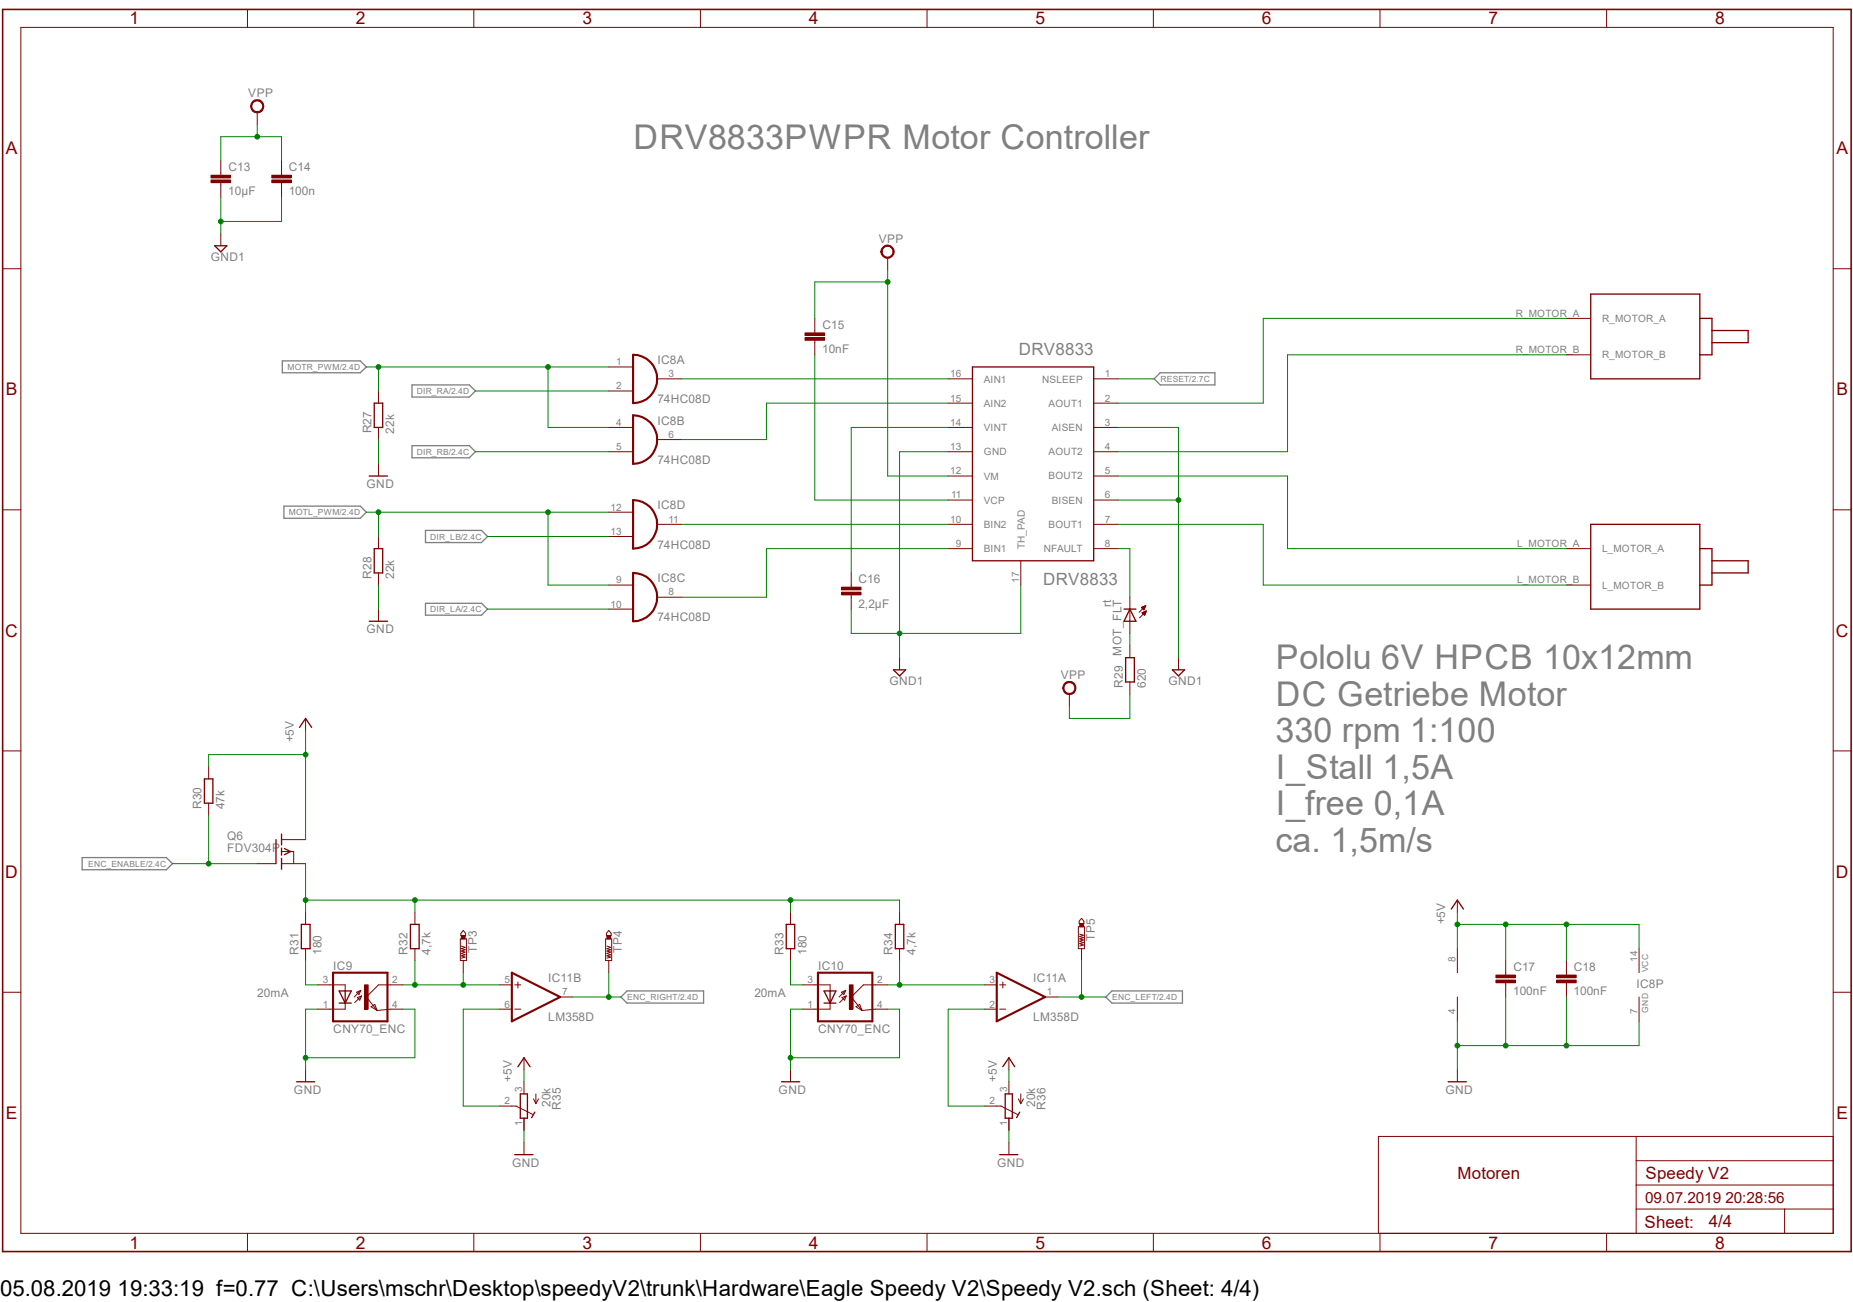
[picture p22: page 4]

05.08.2019 19:33:19 f=0.77 C:\Users\mschr\Desktop\speedyV2\trunk\Hardware\Eagle Speedy V2\Speedy V2.sch (Sheet: 4/4)
