schrmich/speedy_gonzales/Hardware/Bestückungsplan LCD_SHIELD V2.pdf

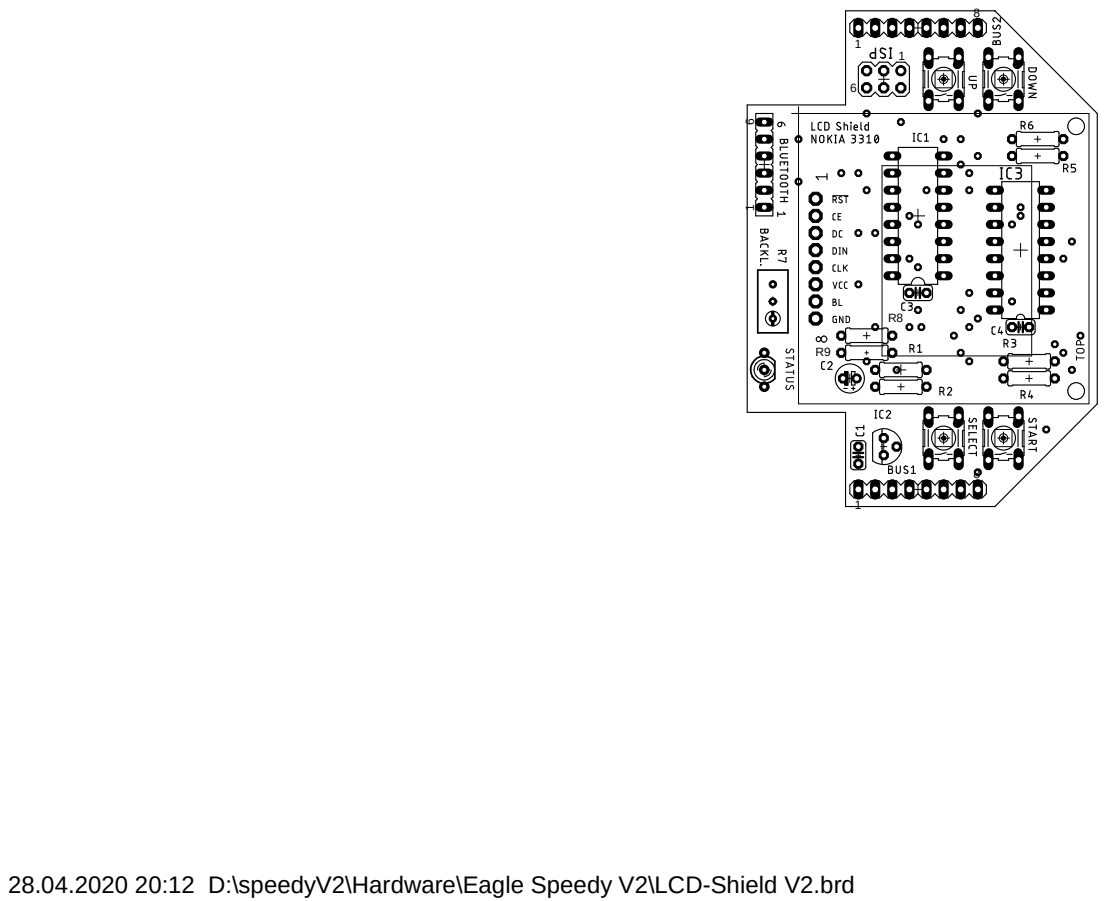
[picture p23: page 1]

28.04.2020 20:12 D:\speedyV2\Hardware\Eagle Speedy V2\LCD-Shield V2.brd
