schrmich/speedy_gonzales/Hardware/BestückungV2.pdf

1 8

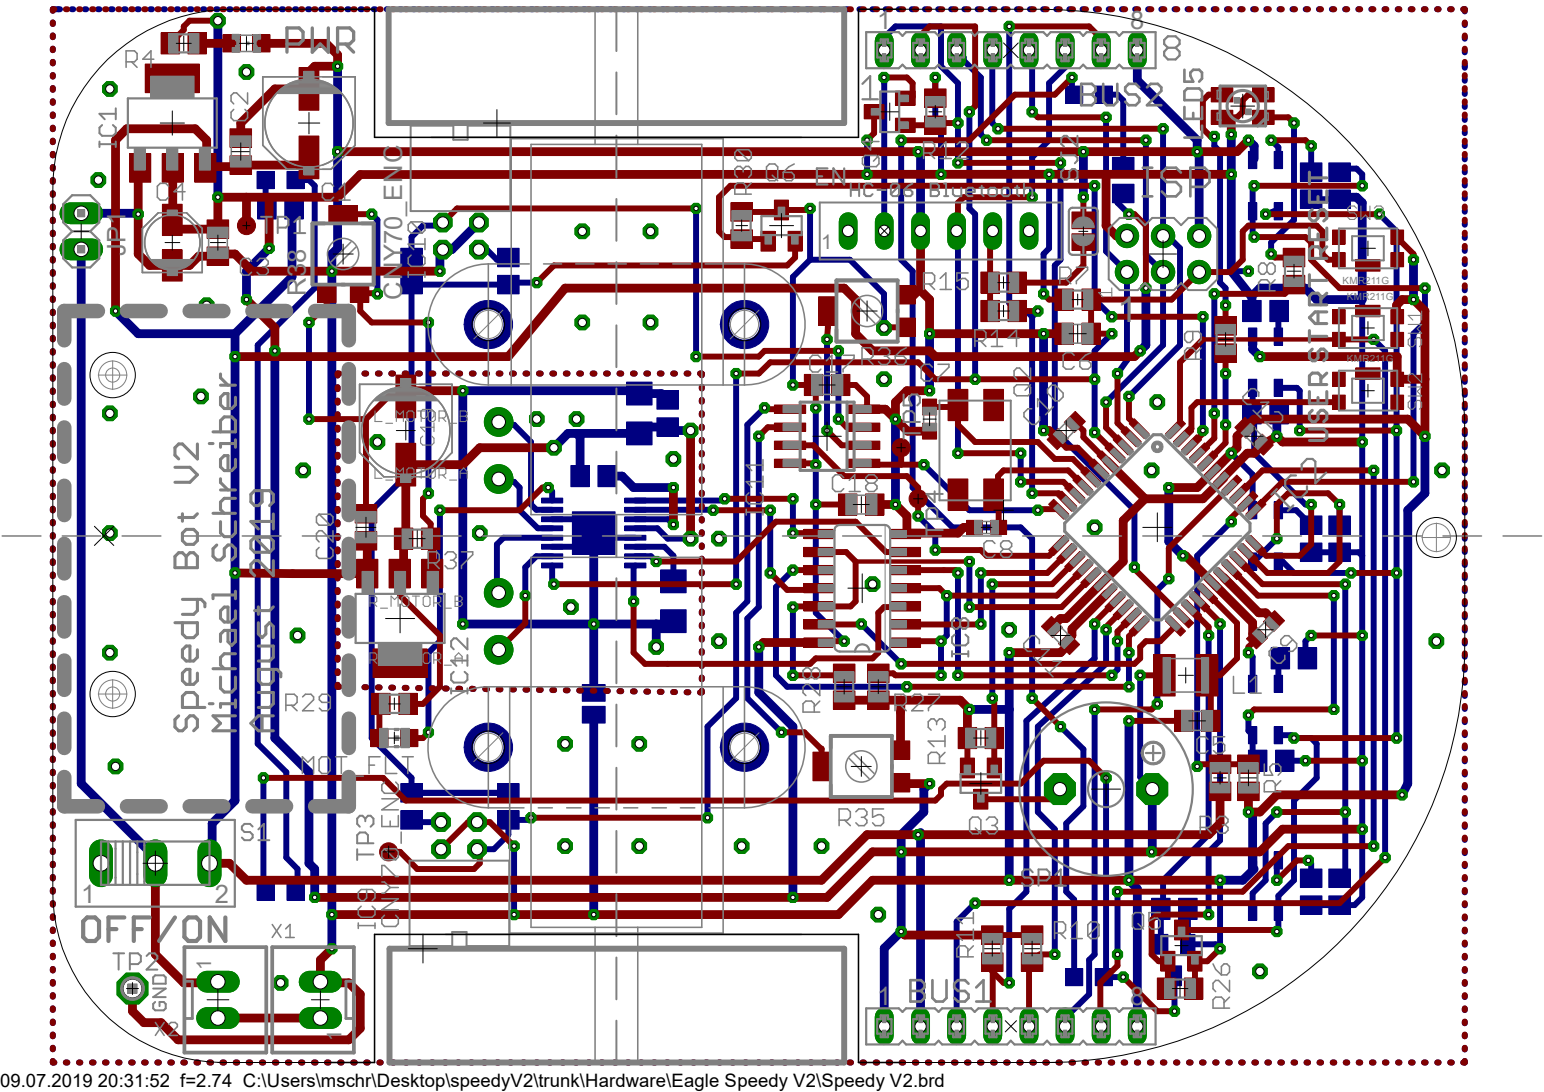
[picture p24: page 1]
1 CNY⁷⁰_ENC; KMR211G KMR211G; KMR211G JP¹; R³⁸

09.07.2019 20:31:52 f=2.74 C:\Users\mschr\Desktop\speedyV2\trunk\Hardware\Eagle Speedy V2\Speedy V2.brd
