schrmich/speedy_gonzales/Hardware/Schaltplan LCD_SHIELD V2.pdf

# 4050N +3V³ +3V³ ¹⁰k

A

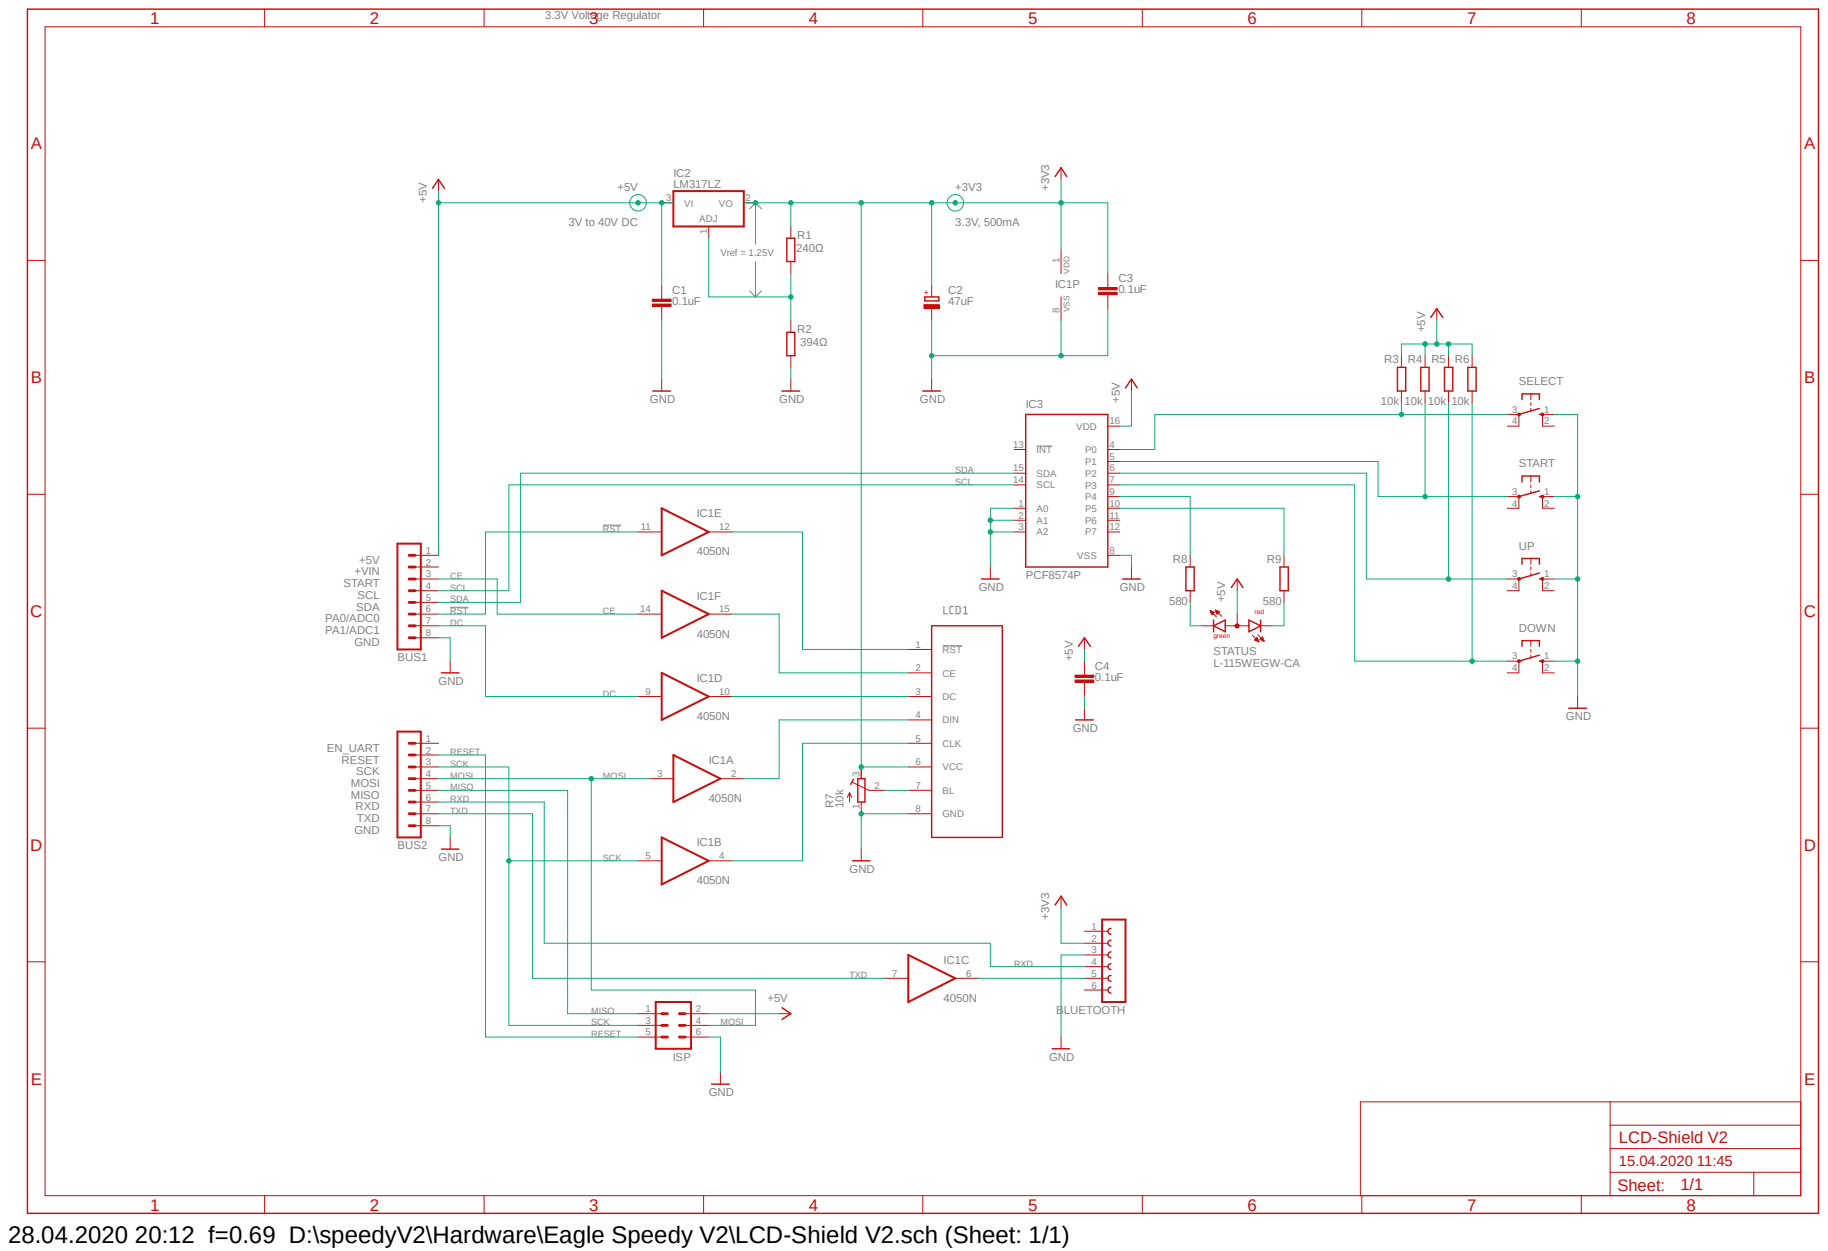
[picture p25: page 1]

4 SCL
5 SDA
6 RST

5 MISO
6 RXD
7 TXD

28.04.2020 20:12 f=0.69 D:\speedyV2\Hardware\Eagle Speedy V2\LCD-Shield V2.sch (Sheet: 1/1)
