schrmich/speedy_gonzales/Hardware/Eagle Speedy V2/Speedy V2.1.brd

## EAGLE design Hardware/Eagle Speedy V2/Speedy V2.1.brd (2021-03-15, an earlier design)

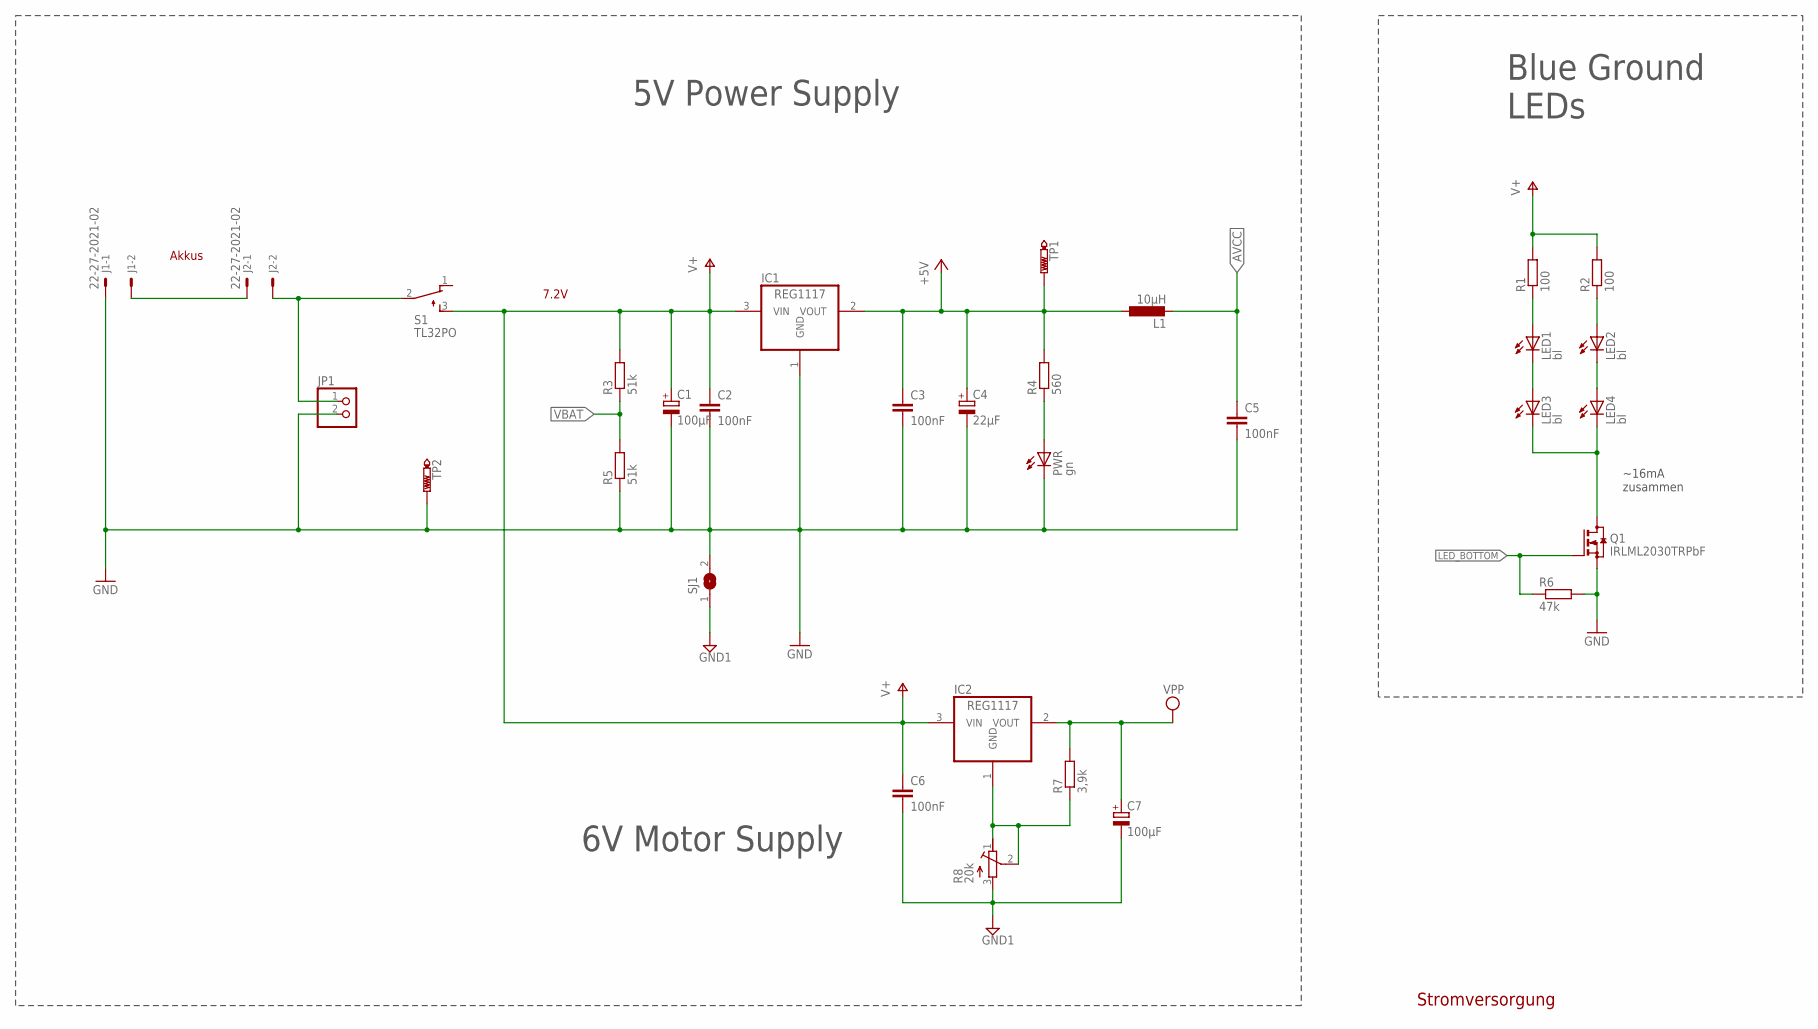
[picture p26: schematic Speedy V2.1.sch, sheet 1, Power]

Parts:
C1, C7: 100µF; PANASONIC_D
C2, C3, C5, C6: 100nF; C0805
C4: 22µF; PANASONIC_B
IC1, IC2: REG1117; SOT223
J1, J2: 22-27-2021-02; 6410-02
JP1: PINHD-1X2; 1X02
L1: 10µH; C1210K
LED1, LED2, LED3, LED4: bl; CHIPLED_0805
PWR: gn; CHIPLED_0805
Q1: IRLML2030TRPbF; SOT23
R1, R2: 100; R0805
R3, R5: 51k; R0805
R4: 560; R0805
R6: 47k; R0805
R7: 3,9k; R0805
R8: 20k; RTRIM3314G
S1: TL32PO; TL3XPO
SJ1: SJ
TP1: PTR1B1,27; B1,27
TP2: PTR1PAD1-13; P1-13

Connections:
+5V: C3.1, C4.+, IC1.2 (VOUT), L1.1, R4.2, TP1.TP; also elsewhere on the board
AVCC: C5.1, L1.2; also elsewhere on the board
GND: C1.-, C2.2, C3.2, C4.-, C5.2, IC1.1 (GND), J1.1, JP1.2, PWR.C, Q1.2 (S), R5.1, R6.2, SJ1.2, TP2.TP; also elsewhere on the board
GND1: C6.2, C7.-, R8.3 (A), SJ1.1; also elsewhere on the board
LED_BOTTOM: Q1.1 (G), R6.1; also elsewhere on the board
unnamed: J1.2, J2.1
unnamed: PWR.A, R4.1
unnamed: J2.2, JP1.1, S1.2
unnamed: LED3.C, LED4.C, Q1.3 (D)
unnamed: LED1.A, R1.1
unnamed: LED1.C, LED3.A
unnamed: LED2.C, LED4.A
unnamed: LED2.A, R2.1
unnamed: IC2.1 (GND), R7.1, R8.1 (E), R8.2 (S)
V+: C1.+, C2.1, C6.1, IC1.3 (VIN), IC2.3 (VIN), R1.2, R2.2, R3.2, S1.3 (S); also elsewhere on the board
VBAT: R3.1, R5.2; also elsewhere on the board
VPP: C7.+, IC2.2 (VOUT), R7.2; also elsewhere on the board

Notes on the sheet:
Stromversorgung
5V Power Supply
Blue Ground LEDs
Akkus
7.2V
~16mA zusammen
6V Motor Supply

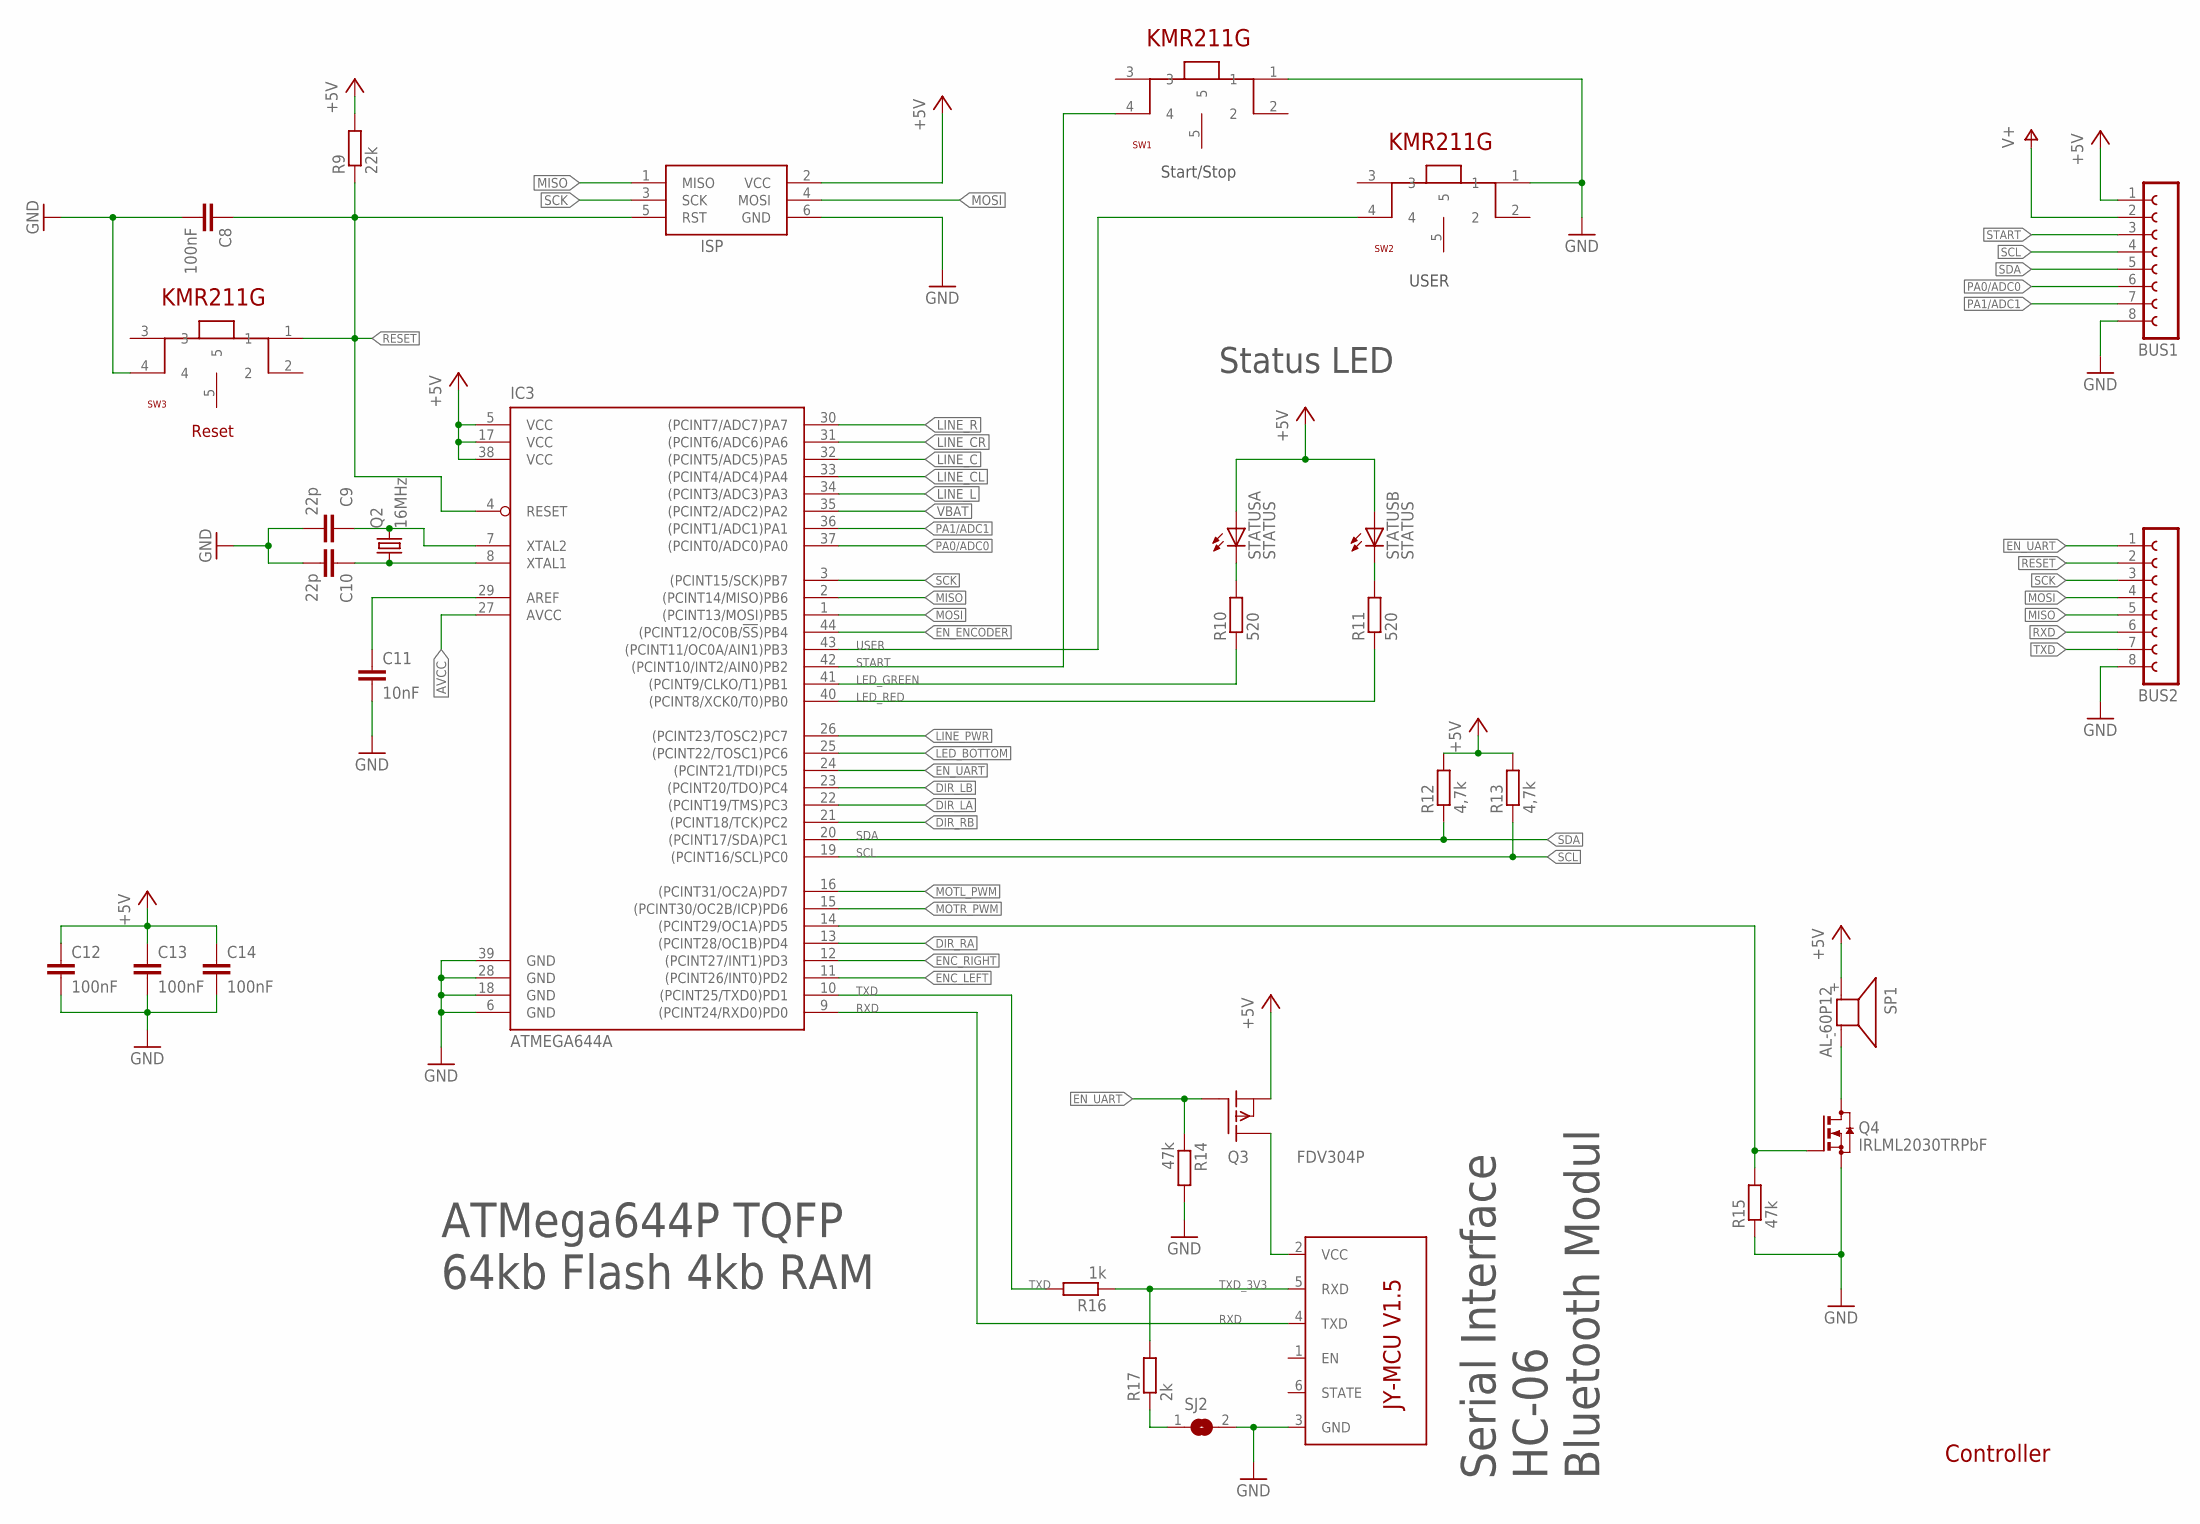
[picture p27: schematic Speedy V2.1.sch, sheet 2, Controller]

Parts:
BUS1, BUS2: FE08-1; FE08
C8: 100nF; C0805
C9, C10: 22p; C0603
C11: 10nF; C0603
C12, C13, C14: 100nF; C0603
IC3: ATMEGA644A; TQFP44
ISP: AVRISP-6; AVRISP
Q2: 16MHz; 7X5MMQUARZ
Q3: FDV304P; SOT23
Q4: IRLML2030TRPbF; SOT23
R9: 22k; R0805
R10, R11: 520; R0805
R12, R13: 4,7k; R0805
R14, R15: 47k; R0805
R16: 1k; R0805
R17: 2k; R0805
SJ2: SJ
SP1: AL-60P12; KSS1201
STATUS: STATUS; P-LCC4-0
SW1, SW2, SW3: KMR211G_SWITCH
U1: BT_BOARD

Connections:
+5V: BUS1.1, C12.1, C13.1, C14.1, IC3.5 (VCC), IC3.17 (VCC), IC3.38 (VCC), ISP.2 (VCC), Q3.S, R9.2, R12.2, R13.2, SP1.+ (1), STATUS.2 (A), STATUS.4 (A); also elsewhere on the board
AVCC: IC3.27 (AVCC); also elsewhere on the board
BUZZER: IC3.14 ((PCINT29/OC1A)PD5), Q4.1 (G), R15.2
DIR_LA: IC3.22 ((PCINT19/TMS)PC3); also elsewhere on the board
DIR_LB: IC3.23 ((PCINT20/TDO)PC4); also elsewhere on the board
DIR_RA: IC3.13 ((PCINT28/OC1B)PD4); also elsewhere on the board
DIR_RB: IC3.21 ((PCINT18/TCK)PC2); also elsewhere on the board
ENC_LEFT: IC3.11 ((PCINT26/INT0)PD2); also elsewhere on the board
ENC_RIGHT: IC3.12 ((PCINT27/INT1)PD3); also elsewhere on the board
EN_ENCODER: IC3.44 ((PCINT12/OC0B/!SS!)PB4); also elsewhere on the board
EN_UART: BUS2.1, IC3.24 ((PCINT21/TDI)PC5), Q3.G, R14.1
GND: BUS1.8, BUS2.8, C8.2, C9.2, C10.2, C11.2, C12.2, C13.2, C14.2, IC3.6 (GND), IC3.18 (GND), IC3.28 (GND), IC3.39 (GND), ISP.6 (GND), Q4.2 (S), R14.2, R15.1, SJ2.2, SW1.1, SW2.1, SW3.4, U1.3 (GND); also elsewhere on the board
LED_BOTTOM: IC3.25 ((PCINT22/TOSC1)PC6); also elsewhere on the board
LED_GREEN: IC3.41 ((PCINT9/CLKO/T1)PB1), R10.1
LED_RED: IC3.40 ((PCINT8/XCK0/T0)PB0), R11.1
LINE_C: IC3.32 ((PCINT5/ADC5)PA5); also elsewhere on the board
LINE_CL: IC3.33 ((PCINT4/ADC4)PA4); also elsewhere on the board
LINE_CR: IC3.31 ((PCINT6/ADC6)PA6); also elsewhere on the board
LINE_L: IC3.34 ((PCINT3/ADC3)PA3); also elsewhere on the board
LINE_PWR: IC3.26 ((PCINT23/TOSC2)PC7); also elsewhere on the board
LINE_R: IC3.30 ((PCINT7/ADC7)PA7); also elsewhere on the board
MISO: BUS2.5, IC3.2 ((PCINT14/MISO)PB6), ISP.1 (MISO)
MOSI: BUS2.4, IC3.1 ((PCINT13/MOSI)PB5), ISP.4 (MOSI)
MOTL_PWM: IC3.16 ((PCINT31/OC2A)PD7); also elsewhere on the board
MOTR_PWM: IC3.15 ((PCINT30/OC2B/ICP)PD6); also elsewhere on the board
unnamed: Q4.3 (D), SP1.- (2)
unnamed: R10.2, STATUS.1 (C)
unnamed: C11.1, IC3.29 (AREF)
unnamed: R17.1, SJ2.1
unnamed: R11.2, STATUS.3 (C)
unnamed: Q3.D, U1.2 (VCC)
unnamed: C9.1, IC3.7 (XTAL2), Q2.P$3 (2)
unnamed: C10.1, IC3.8 (XTAL1), Q2.P$1 (1)
PA0/ADC0: BUS1.6, IC3.37 ((PCINT0/ADC0)PA0)
PA1/ADC1: BUS1.7, IC3.36 ((PCINT1/ADC1)PA1)
RESET: BUS2.2, C8.1, IC3.4 (RESET), ISP.5 (RST), R9.1, SW3.1; also elsewhere on the board
RXD: BUS2.6, IC3.9 ((PCINT24/RXD0)PD0), U1.4 (TXD)
SCK: BUS2.3, IC3.3 ((PCINT15/SCK)PB7), ISP.3 (SCK)
SCL: BUS1.4, IC3.19 ((PCINT16/SCL)PC0), R13.1
SDA: BUS1.5, IC3.20 ((PCINT17/SDA)PC1), R12.1
START: BUS1.3, IC3.42 ((PCINT10/INT2/AIN0)PB2), SW1.4
TXD: BUS2.7, IC3.10 ((PCINT25/TXD0)PD1), R16.2
TXD_3V3: R16.1, R17.2, U1.5 (RXD)
USER: IC3.43 ((PCINT11/OC0A/AIN1)PB3), SW2.4
V+: BUS1.2; also elsewhere on the board
VBAT: IC3.35 ((PCINT2/ADC2)PA2); also elsewhere on the board

Notes on the sheet:
Controller
Start/Stop
Reset
Serial Interface HC-06 Bluetooth Modul
ATMega644P TQFP 64kb Flash 4kb RAM
USER
Status LED

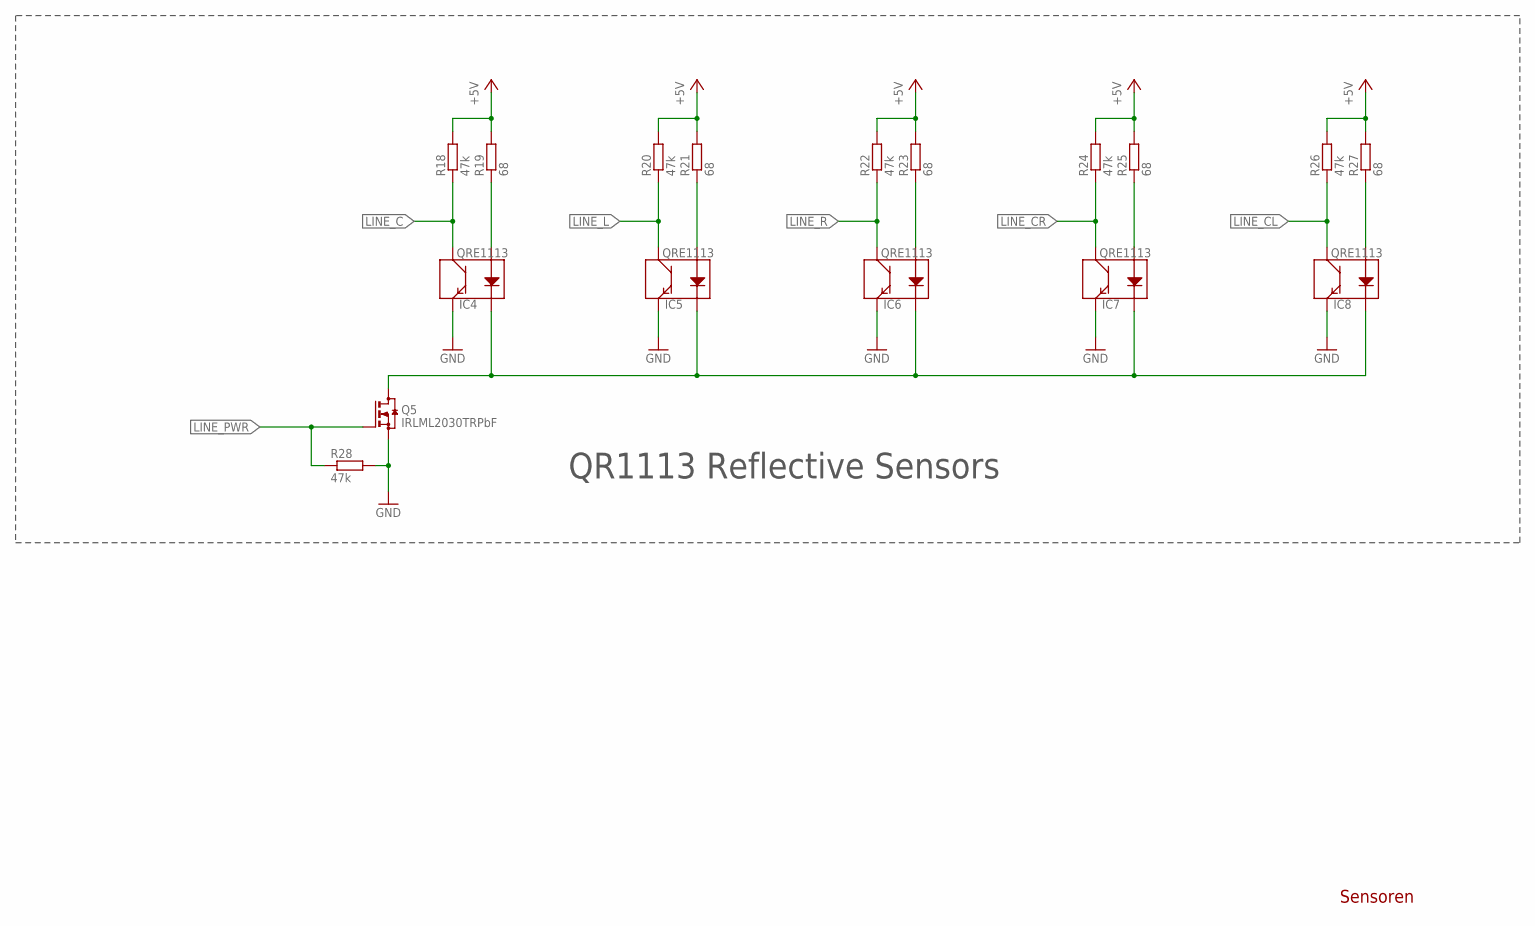
[picture p28: schematic Speedy V2.1.sch, sheet 3, Sensors]

Parts:
IC4, IC5, IC6, IC7, IC8: QRE1113
Q5: IRLML2030TRPbF; SOT23
R18, R20, R22, R24, R26, R28: 47k; R0805
R19, R21, R23, R25, R27: 68; R0805

Connections:
+5V: R18.2, R19.2, R20.2, R21.2, R22.2, R23.2, R24.2, R25.2, R26.2, R27.2; also elsewhere on the board
GND: IC4.4 (E), IC5.4 (E), IC6.4 (E), IC7.4 (E), IC8.4 (E), Q5.2 (S), R28.2; also elsewhere on the board
LINE_C: IC4.3 (C), R18.1; also elsewhere on the board
LINE_CL: IC8.3 (C), R26.1; also elsewhere on the board
LINE_CR: IC7.3 (C), R24.1; also elsewhere on the board
LINE_L: IC5.3 (C), R20.1; also elsewhere on the board
LINE_PWR: Q5.1 (G), R28.1; also elsewhere on the board
LINE_R: IC6.3 (C), R22.1; also elsewhere on the board
unnamed: IC4.2 (K), IC5.2 (K), IC6.2 (K), IC7.2 (K), IC8.2 (K), Q5.3 (D)
unnamed: IC5.1 (A), R21.1
unnamed: IC4.1 (A), R19.1
unnamed: IC6.1 (A), R23.1
unnamed: IC7.1 (A), R25.1
unnamed: IC8.1 (A), R27.1

Notes on the sheet:
Sensoren
QR1113 Reflective Sensors

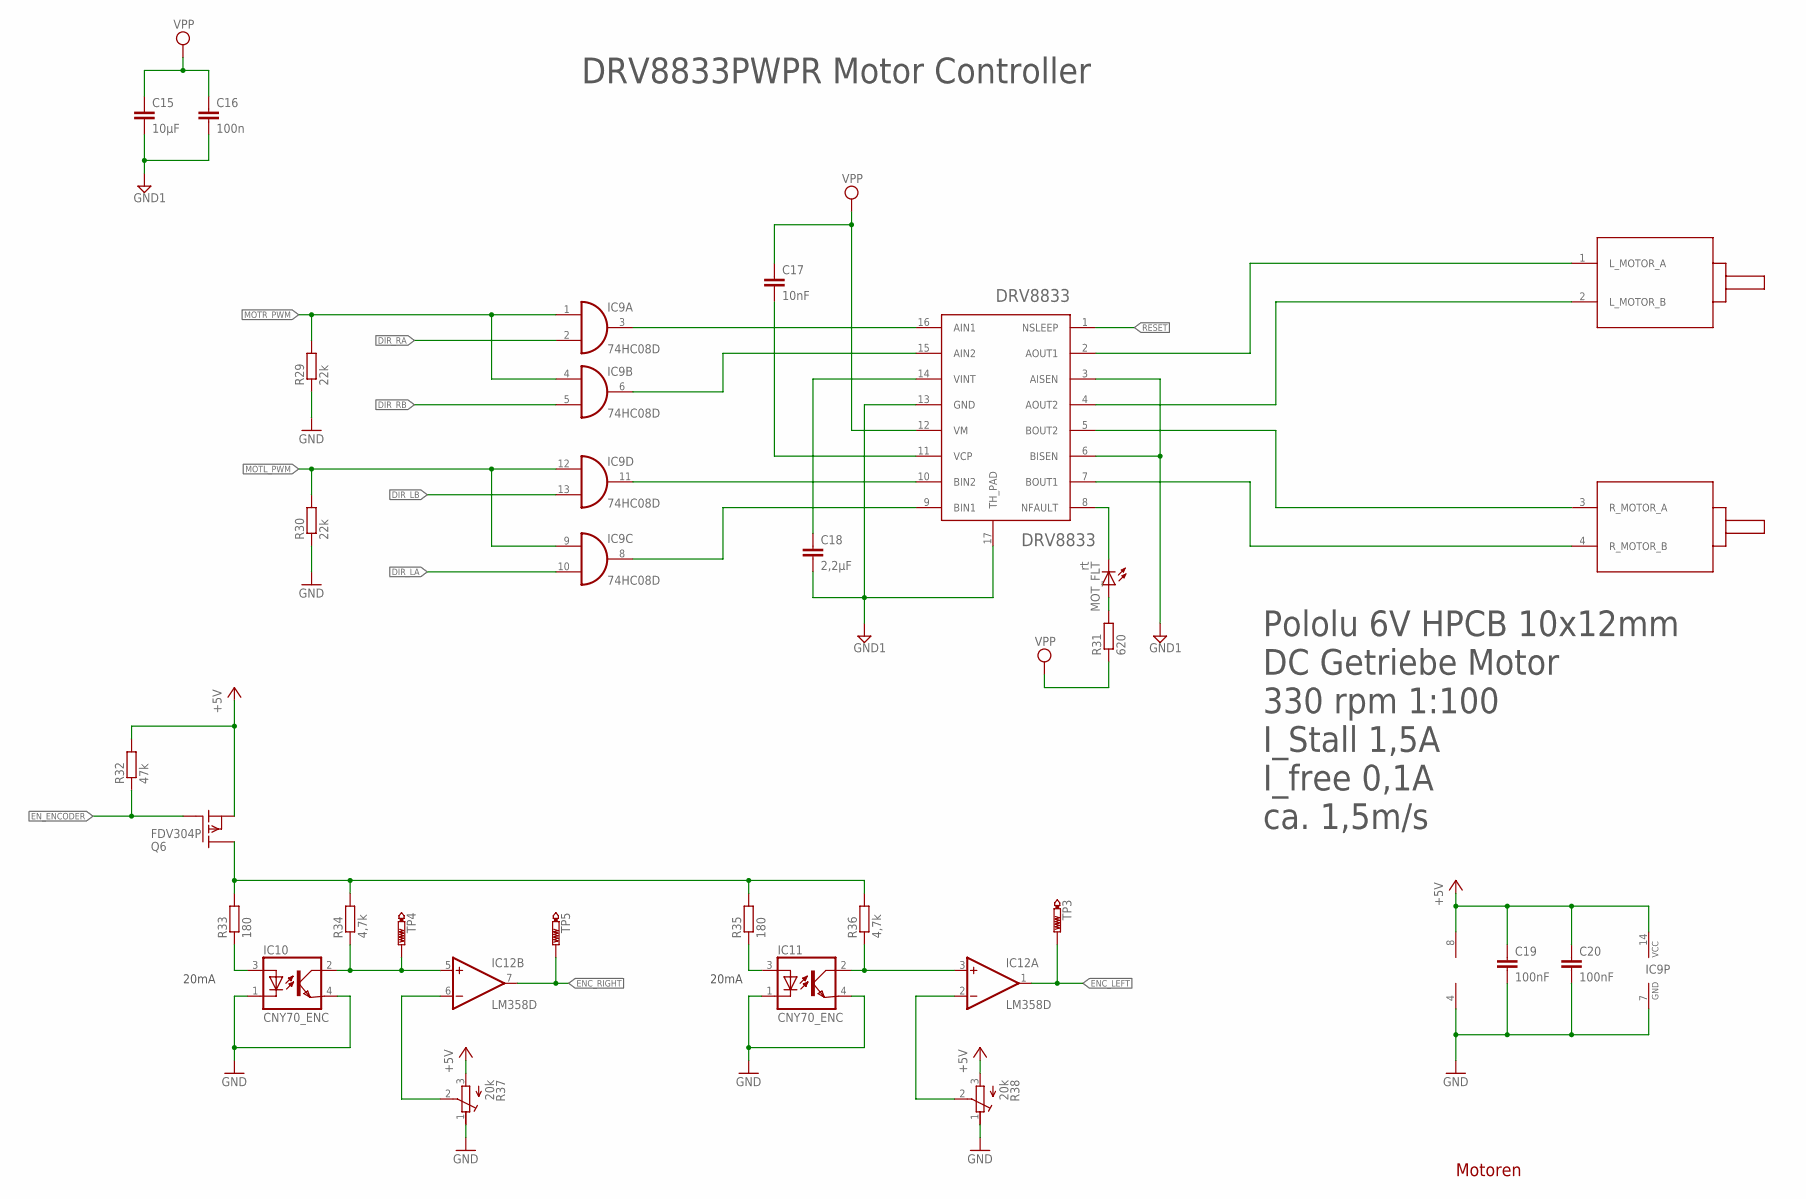
[picture p29: schematic Speedy V2.1.sch, sheet 4, Motors]

Parts:
C15: 10µF; C1206
C16: 100n; C0805
C17: 10nF; C0805
C18: 2,2µF; C1206
C19, C20: 100nF; C0805
IC9: 74HC08D; SO14
IC10, IC11: CNY70_ENC
IC12: LM358D; SO08
MOT_FLT: rt; CHIP-LED0805
Q6: FDV304P; SOT23
R29, R30: 22k; R0805
R31: 620; R0805
R32: 47k; R0805
R33, R35: 180; R0805
R34, R36: 4,7k; R0805
R37, R38: 20k; RTRIM3314G
TP3, TP4, TP5: PTR1B1,27; B1,27
U2: DRV8833; SOP65P640X120-17N
U$1: SPEEDY_MOTOR_MOUNT; FUTURA_V1.0_MOTOT_MOUNT

Connections:
+5V: C19.1, C20.1, IC9.14 (VCC), IC12.8 (V+), Q6.S, R32.2, R37.3 (A), R38.3 (A); also elsewhere on the board
DIR_LA: IC9.10 (I1); also elsewhere on the board
DIR_LB: IC9.13 (I1); also elsewhere on the board
DIR_RA: IC9.2 (I1); also elsewhere on the board
DIR_RB: IC9.5 (I1); also elsewhere on the board
ENC_LEFT: IC12.1 (OUT), TP3.TP; also elsewhere on the board
ENC_RIGHT: IC12.7 (OUT), TP5.TP; also elsewhere on the board
EN_ENCODER: Q6.G, R32.1; also elsewhere on the board
GND: C19.2, C20.2, IC9.7 (GND), IC10.1 (CATH.), IC10.4 (E), IC11.1 (CATH.), IC11.4 (E), IC12.4 (V-), R29.1, R30.1, R37.1 (E), R38.1 (E); also elsewhere on the board
GND1: C15.2, C16.2, C18.2, U2.3 (AISEN), U2.6 (BISEN), U2.13 (GND), U2.17 (TH_PAD); also elsewhere on the board
MOTL_PWM: IC9.9 (I0), IC9.12 (I0), R30.2; also elsewhere on the board
MOTR_PWM: IC9.1 (I0), IC9.4 (I0), R29.2; also elsewhere on the board
unnamed: C18.1, U2.14 (VINT)
unnamed: C17.2, U2.11 (VCP)
unnamed: IC11.3 (A), R35.1
unnamed: IC11.2 (COL), IC12.3 (+IN), R36.1
unnamed: IC10.3 (A), R33.1
unnamed: U2.5 (BOUT2), U$1.3 (R_MOTOR_A)
unnamed: MOT_FLT.A, R31.2
unnamed: MOT_FLT.C, U2.8 (NFAULT)
unnamed: IC9.3 (O), U2.16 (AIN1)
unnamed: IC9.6 (O), U2.15 (AIN2)
unnamed: IC9.11 (O), U2.10 (BIN2)
unnamed: IC9.8 (O), U2.9 (BIN1)
unnamed: IC10.2 (COL), IC12.5 (+IN), R34.1, TP4.TP
unnamed: IC12.6 (-IN), R37.2 (S)
unnamed: U2.7 (BOUT1), U$1.4 (R_MOTOR_B)
unnamed: U2.4 (AOUT2), U$1.2 (L_MOTOR_B)
unnamed: U2.2 (AOUT1), U$1.1 (L_MOTOR_A)
unnamed: IC12.2 (-IN), R38.2 (S)
unnamed: Q6.D, R33.2, R34.2, R35.2, R36.2
RESET: U2.1 (NSLEEP); also elsewhere on the board
VPP: C15.1, C16.1, C17.1, R31.1, U2.12 (VM); also elsewhere on the board

Notes on the sheet:
Motoren
DRV8833PWPR Motor Controller
Pololu 6V HPCB 10x12mm DC Getriebe Motor 330 rpm 1:100 I_Stall 1,5A I_free 0,1A ca. 1,5m/s
20mA

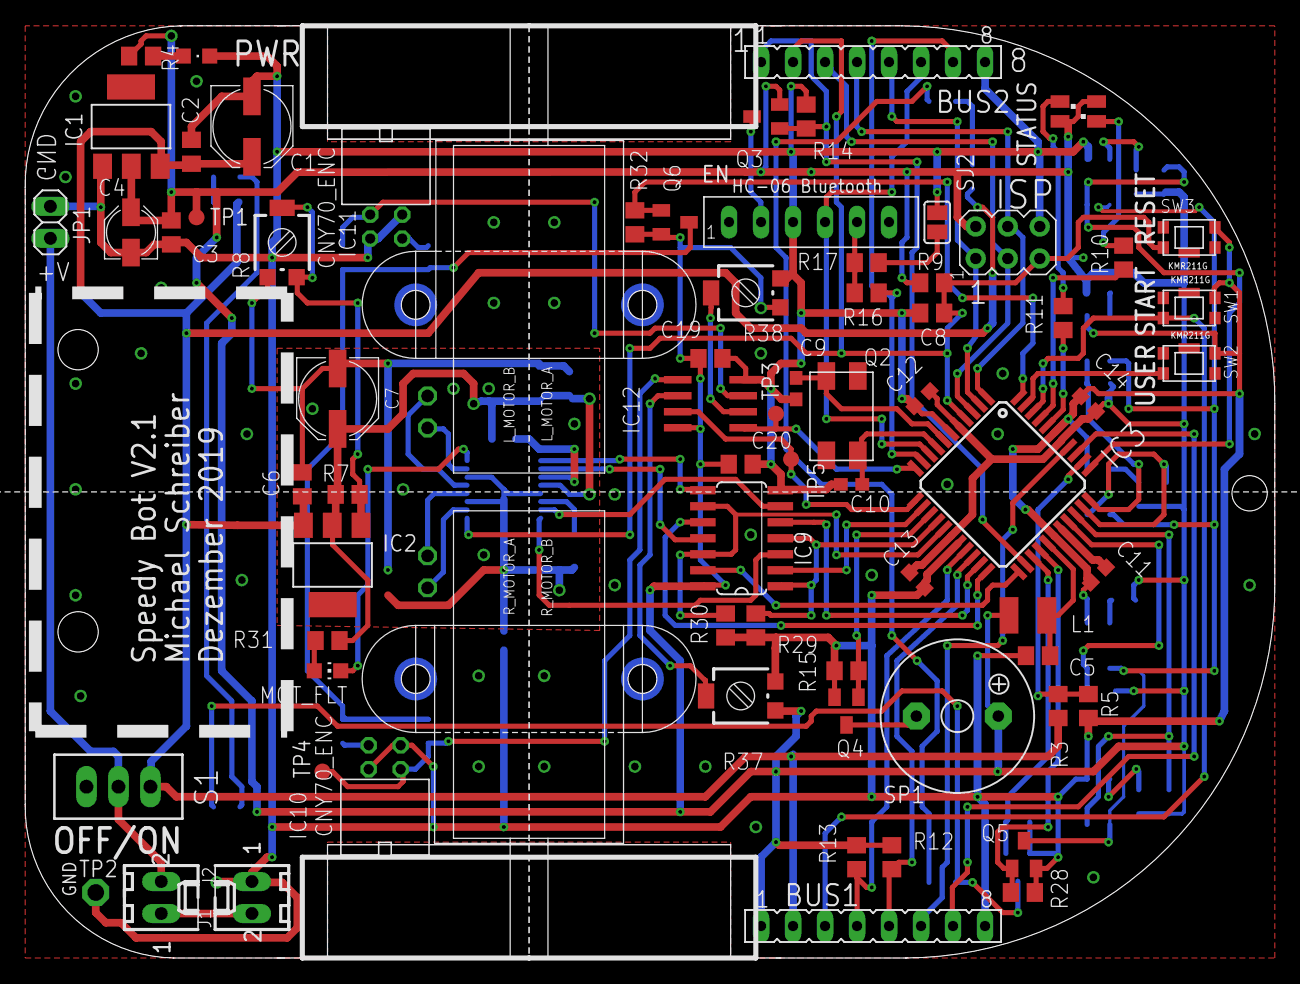
[picture p30: board Hardware/Eagle Speedy V2/Speedy V2.1.brd from above]

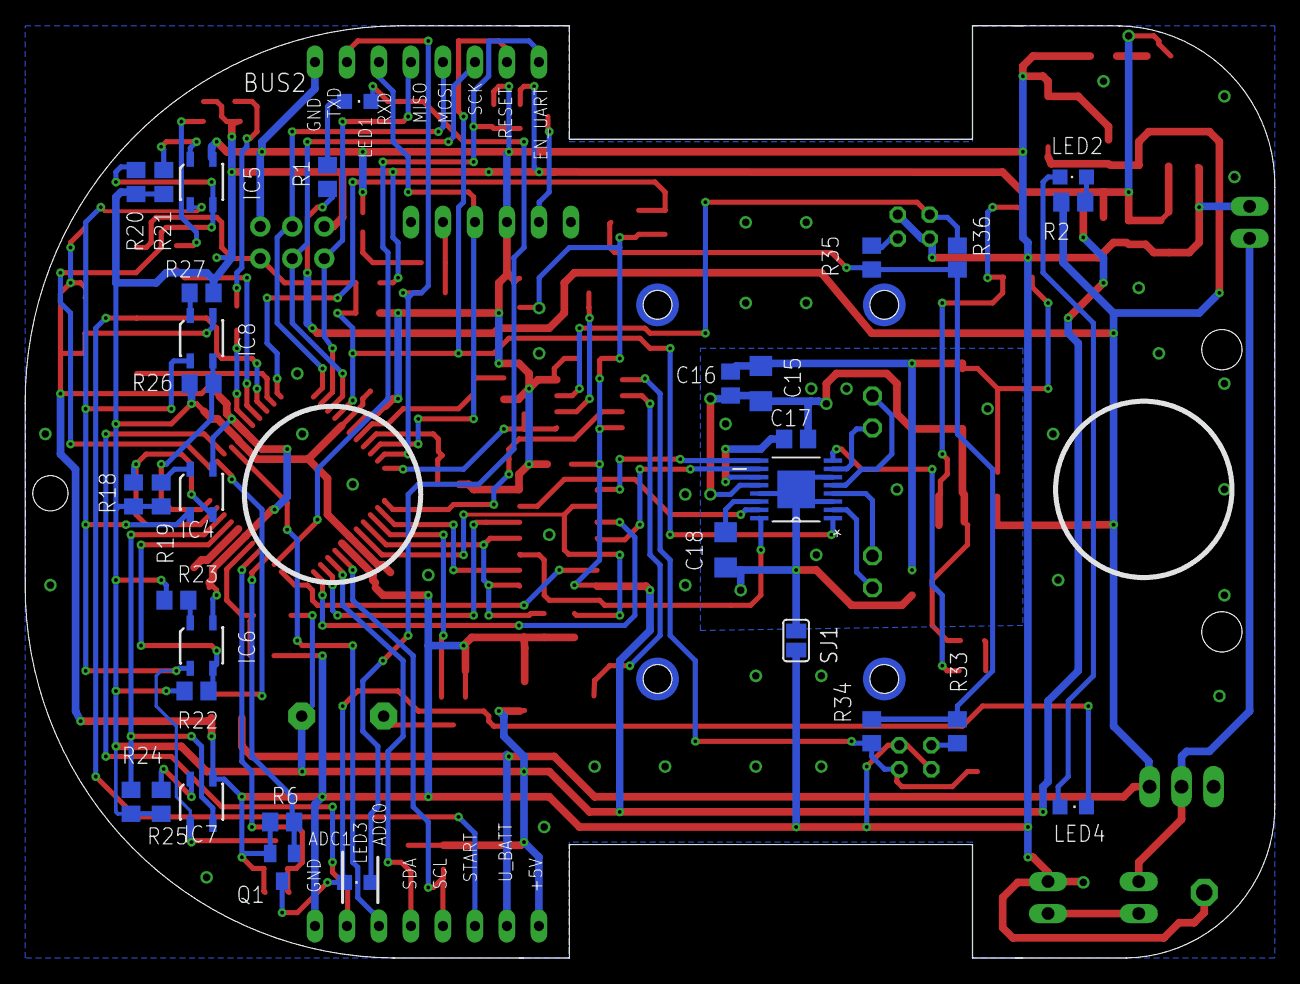
[picture p31: board Hardware/Eagle Speedy V2/Speedy V2.1.brd from below]

Board: 2 copper layers, 99.2 x 74.0 mm, 105 parts (33 on the bottom side), 82 nets.
