schrmich/speedy_gonzales/Hardware/Eagle Speedy V2 Alt/Speedy V2.1.brd

## EAGLE design Hardware/Eagle Speedy V2 Alt/Speedy V2.1.brd (2021-03-15)

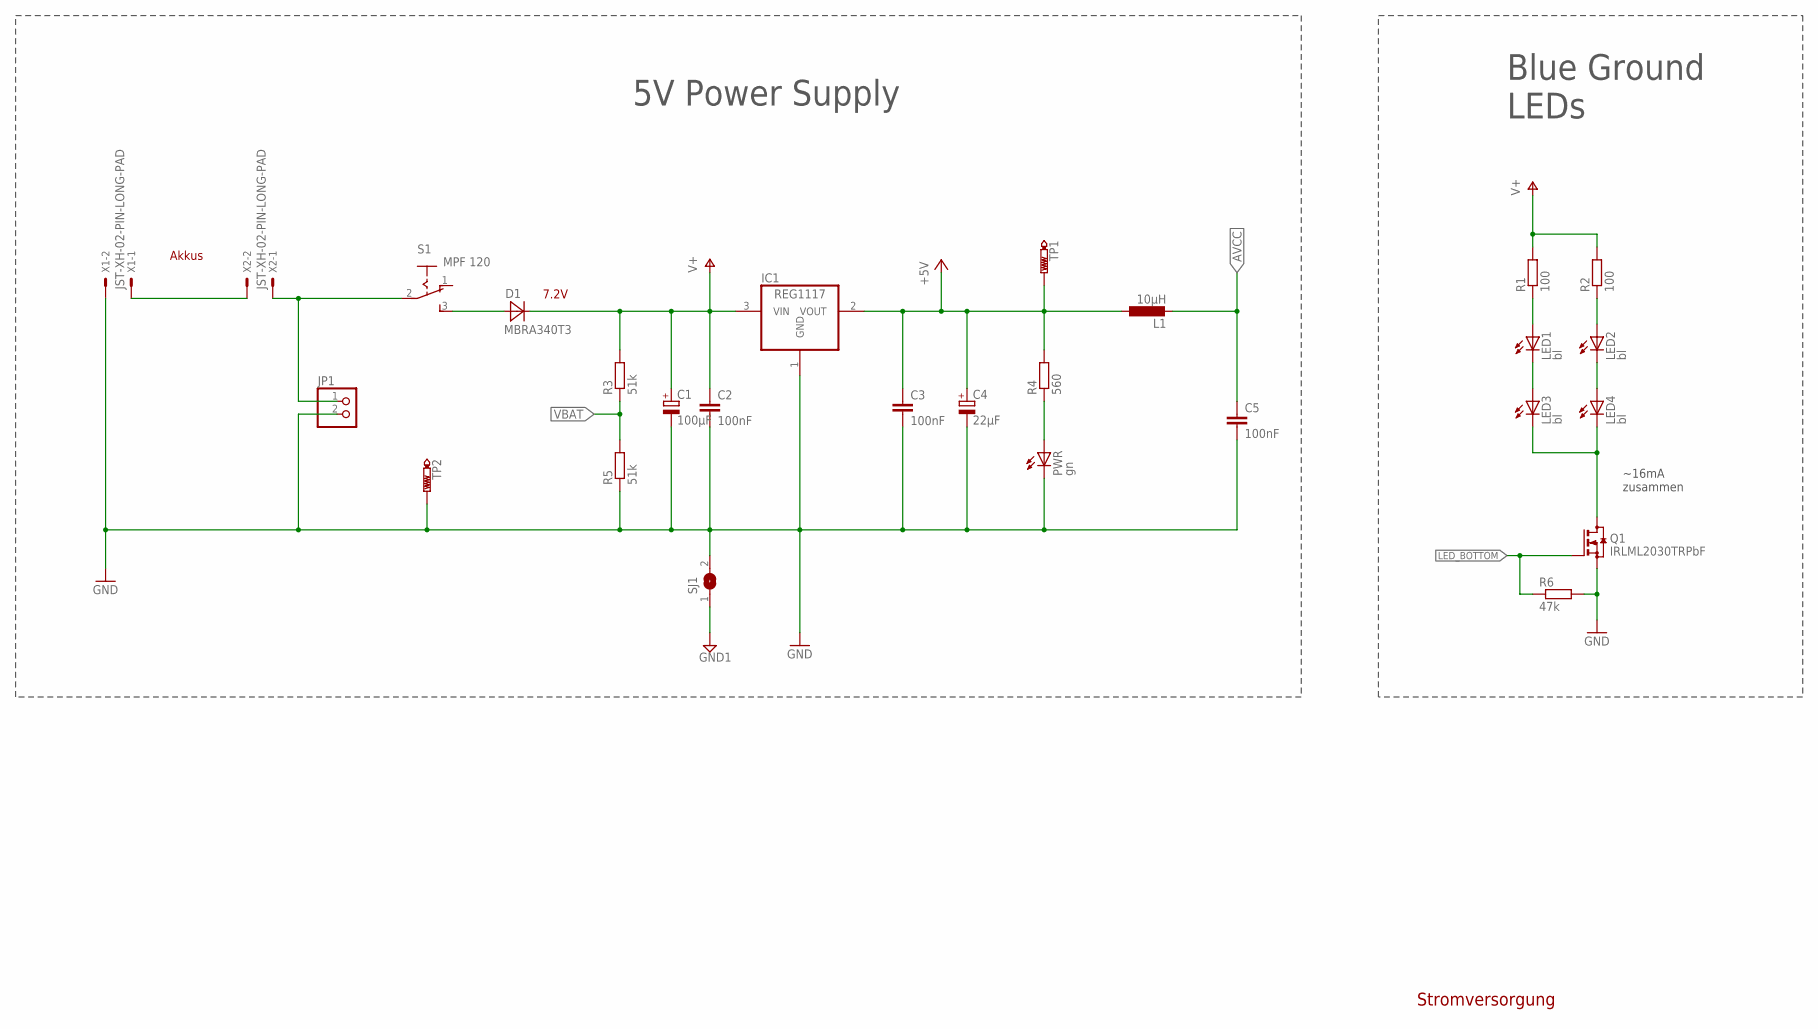
[picture p32: schematic Speedy V2.1.sch, sheet 1, Power]

Parts:
C1: 100µF; PANASONIC_D
C2, C3, C5: 100nF; C0805
C4: 22µF; PANASONIC_B
D1: MBRA340T3; SMA
IC1: REG1117; SOT223
JP1: PINHD-1X2; 1X02
L1: 10µH; C1210K
LED1, LED2, LED3, LED4: bl; CHIPLED_0805
PWR: gn; CHIPLED_0805
Q1: IRLML2030TRPbF; SOT23
R1, R2: 100; R0805
R3, R5: 51k; R0805
R4: 560; R0805
R6: 47k; R0805
S1: MPF 120; 255SB
SJ1: SJ
TP1: PTR1B1,27; B1,27
TP2: PTR1PAD1-13; P1-13
X1, X2: JST-XH-02-PIN-LONG-PAD; JST-XH-02-PACKAGE-LONG-PAD

Connections:
+5V: C3.1, C4.+, IC1.2 (VOUT), L1.1, R4.2, TP1.TP; also elsewhere on the board
AVCC: C5.1, L1.2; also elsewhere on the board
GND: C1.-, C2.2, C3.2, C4.-, C5.2, IC1.1 (GND), JP1.2, PWR.C, Q1.2 (S), R5.1, R6.2, SJ1.2, TP2.TP, X1.2; also elsewhere on the board
GND1: SJ1.1; also elsewhere on the board
LED_BOTTOM: Q1.1 (G), R6.1; also elsewhere on the board
unnamed: X1.1, X2.2
unnamed: PWR.A, R4.1
unnamed: JP1.1, S1.2, X2.1
unnamed: LED3.C, LED4.C, Q1.3 (D)
unnamed: D1.A, S1.3 (S)
unnamed: LED1.A, R1.1
unnamed: LED1.C, LED3.A
unnamed: LED2.C, LED4.A
unnamed: LED2.A, R2.1
V+: C1.+, C2.1, D1.C, IC1.3 (VIN), R1.2, R2.2, R3.2; also elsewhere on the board
VBAT: R3.1, R5.2; also elsewhere on the board

Notes on the sheet:
Stromversorgung
5V Power Supply
Blue Ground LEDs
Akkus
7.2V
~16mA zusammen
