schrmich/speedy_gonzales/Hardware/Eagle Speedy V2 Alt/Speedy V2.1.brd

## EAGLE design Hardware/Eagle Speedy V2 Alt/Speedy V2.1.brd (continued)

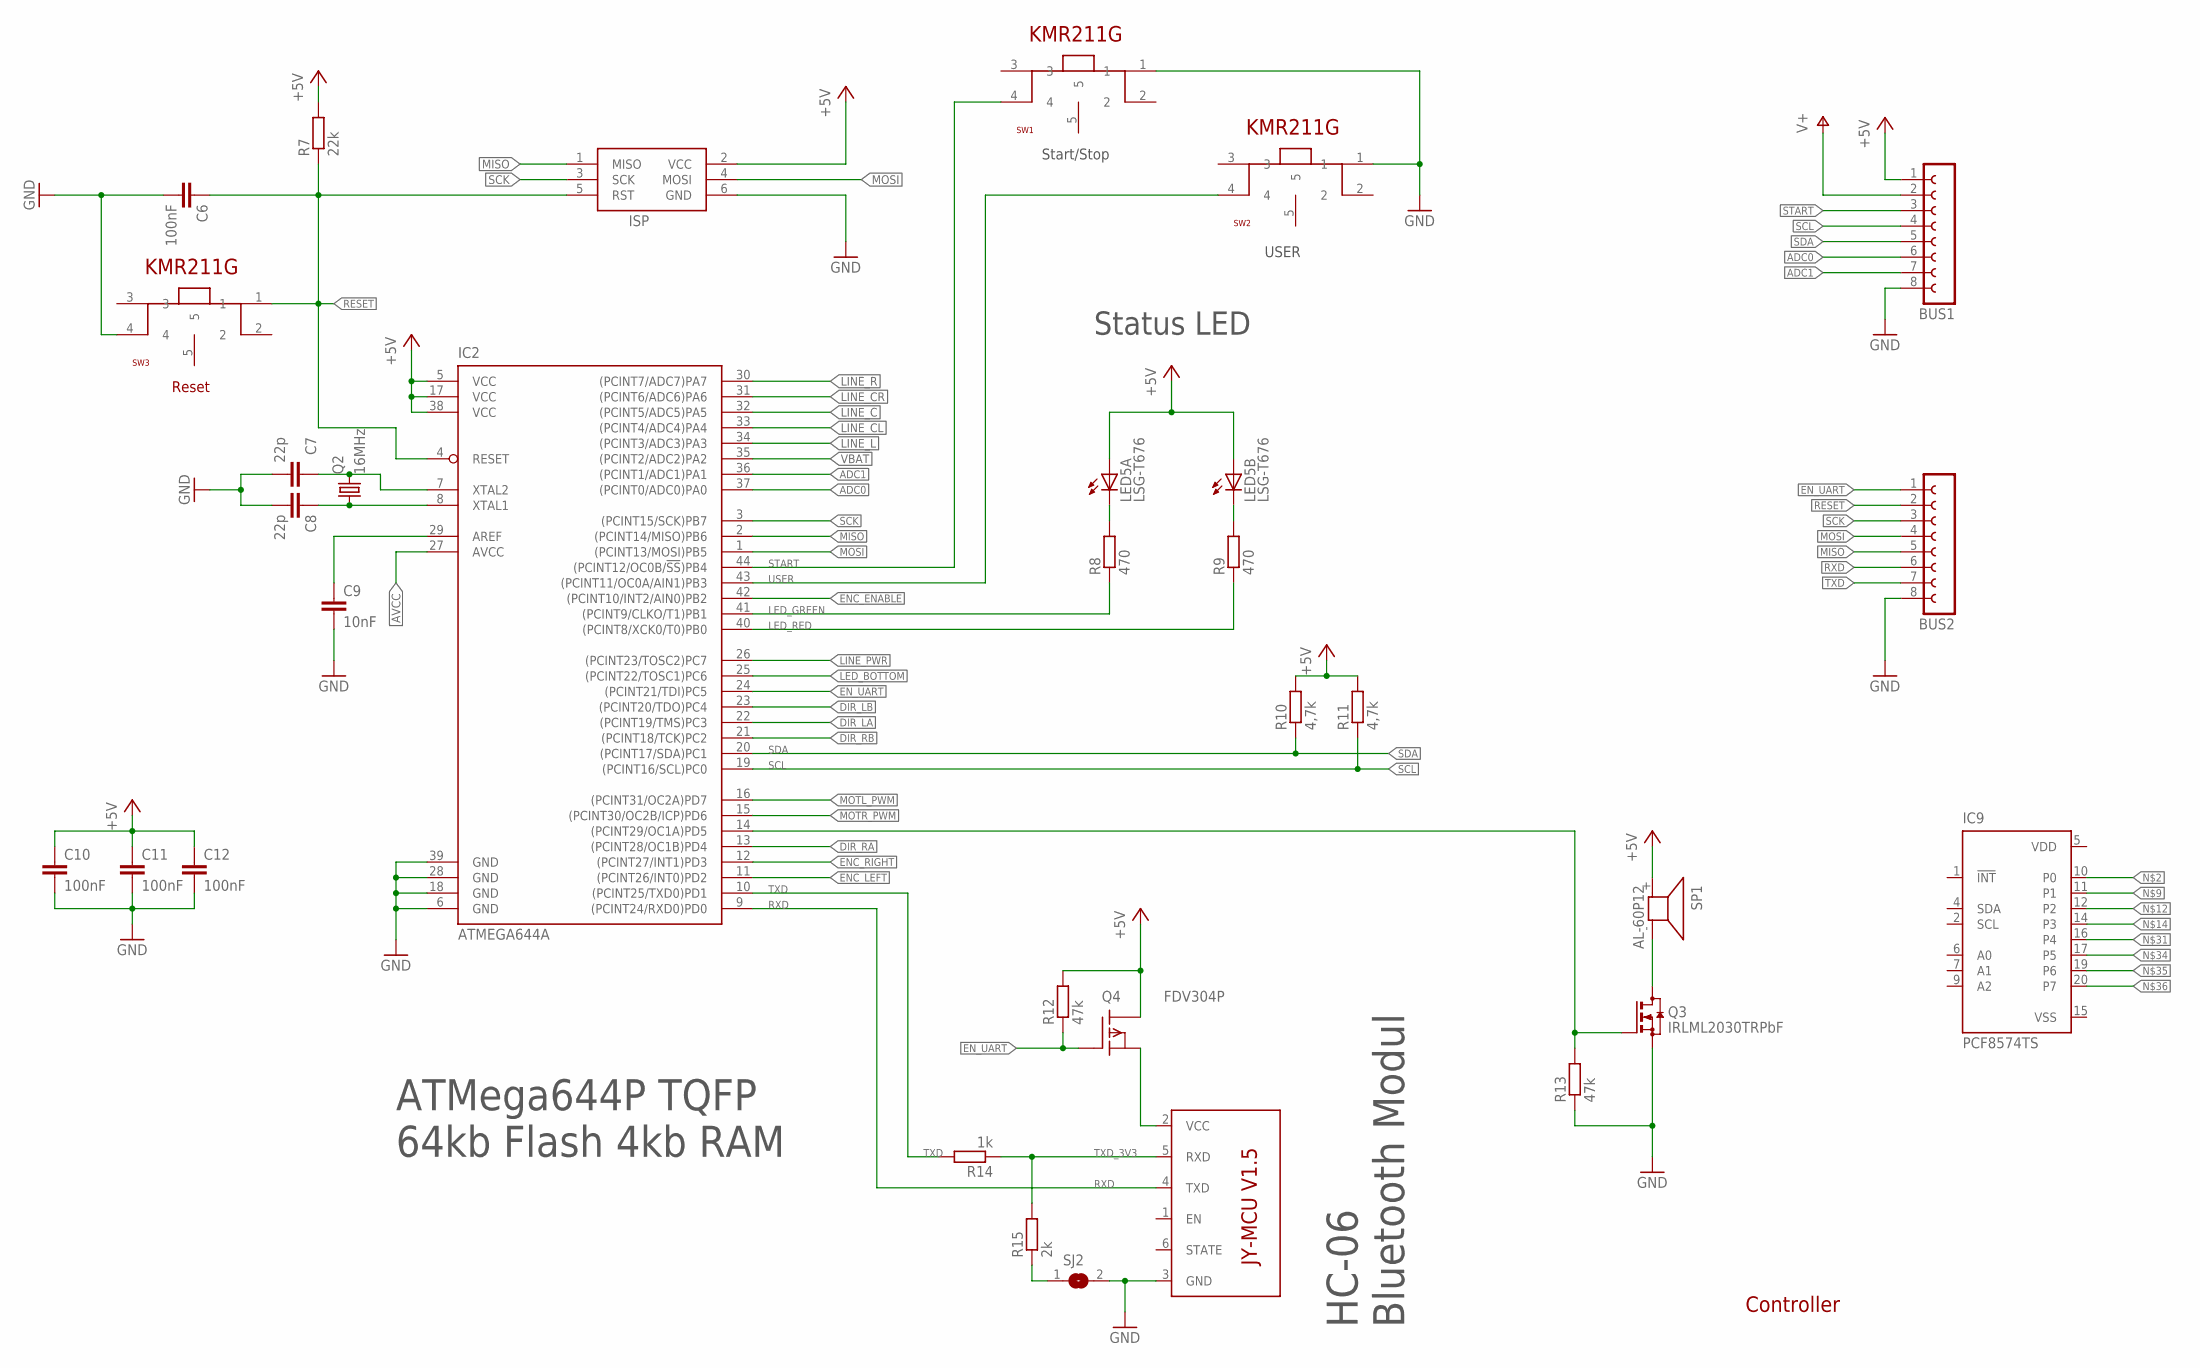
[picture p33: schematic Speedy V2.1.sch, sheet 2, Controller]

Parts:
BUS1, BUS2: FE08-1; FE08
C6: 100nF; C0805
C7, C8: 22p; C0603
C9: 10nF; C0603
C10, C11, C12: 100nF; C0603
IC2: ATMEGA644A; TQFP44
IC9: PCF8574TS; SSOP20
ISP: AVRISP-6; AVRISP
LED5: LSG-T676; P-LCC4-0
Q2: 16MHz; 7X5MMQUARZ
Q3: IRLML2030TRPbF; SOT23
Q4: FDV304P; SOT23
R7: 22k; R0805
R8, R9: 470; R0805
R10, R11: 4,7k; R0805
R12, R13: 47k; R0805
R14: 1k; R0805
R15: 2k; R0805
SJ2: SJ
SP1: AL-60P12; KSS1201
SW1, SW2, SW3: KMR211G_SWITCH
U1: BT_BOARD

Connections:
+5V: BUS1.1, C10.1, C11.1, C12.1, IC2.5 (VCC), IC2.17 (VCC), IC2.38 (VCC), ISP.2 (VCC), LED5.2 (A), LED5.4 (A), Q4.D, R7.2, R10.2, R11.2, R12.2, SP1.+ (1); also elsewhere on the board
ADC0: BUS1.6, IC2.37 ((PCINT0/ADC0)PA0)
ADC1: BUS1.7, IC2.36 ((PCINT1/ADC1)PA1)
AVCC: IC2.27 (AVCC); also elsewhere on the board
BUZZER: IC2.14 ((PCINT29/OC1A)PD5), Q3.1 (G), R13.2
DIR_LA: IC2.22 ((PCINT19/TMS)PC3); also elsewhere on the board
DIR_LB: IC2.23 ((PCINT20/TDO)PC4); also elsewhere on the board
DIR_RA: IC2.13 ((PCINT28/OC1B)PD4); also elsewhere on the board
DIR_RB: IC2.21 ((PCINT18/TCK)PC2); also elsewhere on the board
ENC_ENABLE: IC2.42 ((PCINT10/INT2/AIN0)PB2)
ENC_LEFT: IC2.11 ((PCINT26/INT0)PD2)
ENC_RIGHT: IC2.12 ((PCINT27/INT1)PD3)
EN_UART: BUS2.1, IC2.24 ((PCINT21/TDI)PC5), Q4.G, R12.1
GND: BUS1.8, BUS2.8, C6.2, C7.2, C8.2, C9.2, C10.2, C11.2, C12.2, IC2.6 (GND), IC2.18 (GND), IC2.28 (GND), IC2.39 (GND), ISP.6 (GND), Q3.2 (S), R13.1, SJ2.2, SW1.1, SW2.1, SW3.4, U1.3 (GND); also elsewhere on the board
LED_BOTTOM: IC2.25 ((PCINT22/TOSC1)PC6); also elsewhere on the board
LED_GREEN: IC2.41 ((PCINT9/CLKO/T1)PB1), R8.1
LED_RED: IC2.40 ((PCINT8/XCK0/T0)PB0), R9.1
LINE_C: IC2.32 ((PCINT5/ADC5)PA5); also elsewhere on the board
LINE_CL: IC2.33 ((PCINT4/ADC4)PA4); also elsewhere on the board
LINE_CR: IC2.31 ((PCINT6/ADC6)PA6); also elsewhere on the board
LINE_L: IC2.34 ((PCINT3/ADC3)PA3); also elsewhere on the board
LINE_PWR: IC2.26 ((PCINT23/TOSC2)PC7); also elsewhere on the board
LINE_R: IC2.30 ((PCINT7/ADC7)PA7); also elsewhere on the board
MISO: BUS2.5, IC2.2 ((PCINT14/MISO)PB6), ISP.1 (MISO)
MOSI: BUS2.4, IC2.1 ((PCINT13/MOSI)PB5), ISP.4 (MOSI)
MOTL_PWM: IC2.16 ((PCINT31/OC2A)PD7); also elsewhere on the board
MOTR_PWM: IC2.15 ((PCINT30/OC2B/ICP)PD6); also elsewhere on the board
unnamed: Q3.3 (D), SP1.- (2)
unnamed: LED5.1 (C), R8.2
unnamed: C9.1, IC2.29 (AREF)
unnamed: R15.1, SJ2.1
unnamed: LED5.3 (C), R9.2
unnamed: Q4.S, U1.2 (VCC)
unnamed: C7.1, IC2.7 (XTAL2), Q2.P$3 (2)
unnamed: C8.1, IC2.8 (XTAL1), Q2.P$1 (1)
RESET: BUS2.2, C6.1, IC2.4 (RESET), ISP.5 (RST), R7.1, SW3.1; also elsewhere on the board
RXD: BUS2.6, IC2.9 ((PCINT24/RXD0)PD0), U1.4 (TXD)
SCK: BUS2.3, IC2.3 ((PCINT15/SCK)PB7), ISP.3 (SCK)
SCL: BUS1.4, IC2.19 ((PCINT16/SCL)PC0), R11.1
SDA: BUS1.5, IC2.20 ((PCINT17/SDA)PC1), R10.1
START: BUS1.3, IC2.44 ((PCINT12/OC0B/!SS!)PB4), SW1.4
TXD: BUS2.7, IC2.10 ((PCINT25/TXD0)PD1), R14.2
TXD_3V3: R14.1, R15.2, U1.5 (RXD)
USER: IC2.43 ((PCINT11/OC0A/AIN1)PB3), SW2.4
V+: BUS1.2; also elsewhere on the board
VBAT: IC2.35 ((PCINT2/ADC2)PA2); also elsewhere on the board
VDD: IC9.5 (VDD)
VSS: IC9.15 (VSS)

Notes on the sheet:
Controller
Start/Stop
Reset
HC-06 Bluetooth Modul
ATMega644P TQFP 64kb Flash 4kb RAM
USER
Status LED

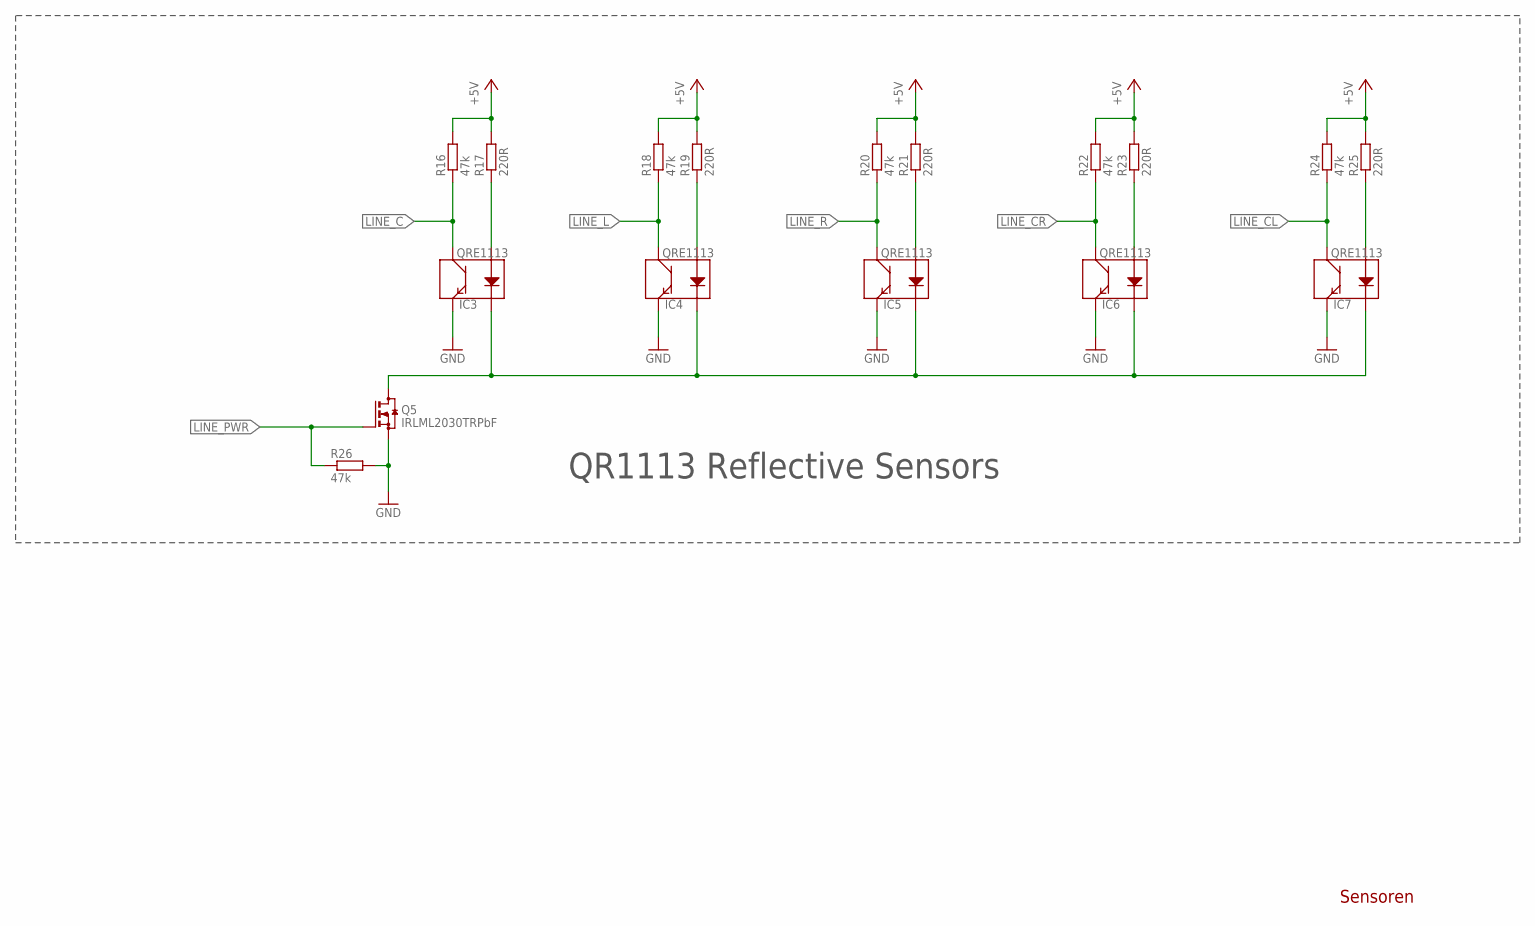
[picture p34: schematic Speedy V2.1.sch, sheet 3, Sensors]

Parts:
IC3, IC4, IC5, IC6, IC7: QRE1113
Q5: IRLML2030TRPbF; SOT23
R16, R18, R20, R22, R24, R26: 47k; R0805
R17, R19, R21, R23, R25: 220R; R0805

Connections:
+5V: R16.2, R17.2, R18.2, R19.2, R20.2, R21.2, R22.2, R23.2, R24.2, R25.2; also elsewhere on the board
GND: IC3.4 (E), IC4.4 (E), IC5.4 (E), IC6.4 (E), IC7.4 (E), Q5.2 (S), R26.2; also elsewhere on the board
LINE_C: IC3.3 (C), R16.1; also elsewhere on the board
LINE_CL: IC7.3 (C), R24.1; also elsewhere on the board
LINE_CR: IC6.3 (C), R22.1; also elsewhere on the board
LINE_L: IC4.3 (C), R18.1; also elsewhere on the board
LINE_PWR: Q5.1 (G), R26.1; also elsewhere on the board
LINE_R: IC5.3 (C), R20.1; also elsewhere on the board
unnamed: IC3.2 (K), IC4.2 (K), IC5.2 (K), IC6.2 (K), IC7.2 (K), Q5.3 (D)
unnamed: IC4.1 (A), R19.1
unnamed: IC3.1 (A), R17.1
unnamed: IC5.1 (A), R21.1
unnamed: IC6.1 (A), R23.1
unnamed: IC7.1 (A), R25.1

Notes on the sheet:
Sensoren
QR1113 Reflective Sensors

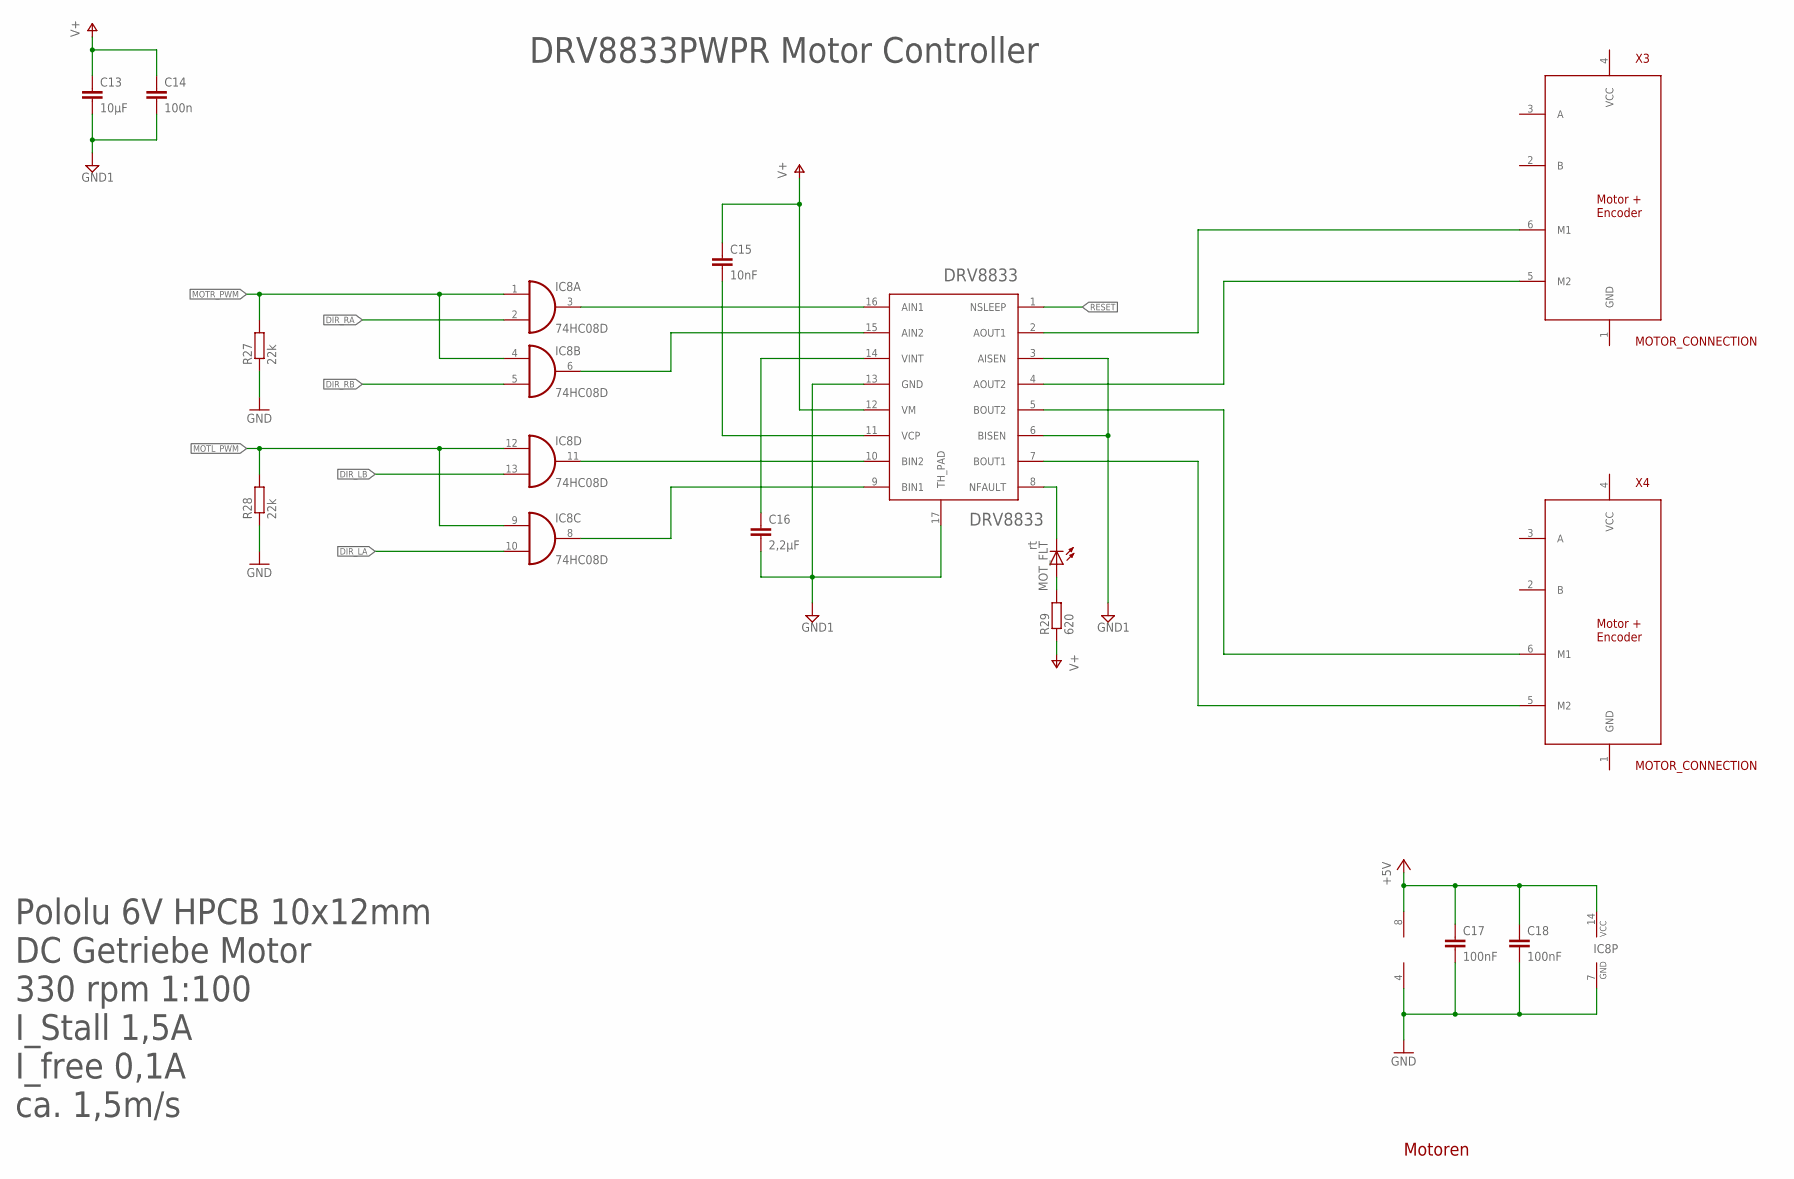
[picture p35: schematic Speedy V2.1.sch, sheet 4, Motors]

Parts:
C13: 10µF; C1206
C14: 100n; C0805
C15: 10nF; C0805
C16: 2,2µF; C1206
C17, C18: 100nF; C0805
IC8: 74HC08D; SO14
IC11: LM358D; SO08
MOT_FLT: rt; CHIP-LED0805
R27, R28: 22k; R0805
R29: 620; R0805
U3: DRV8833; SOP65P640X120-17N
X3, X4: MOTOR_CONNECTION; 2X03

Connections:
+5V: C17.1, C18.1, IC8.14 (VCC), IC11.8 (V+); also elsewhere on the board
DIR_LA: IC8.10 (I1); also elsewhere on the board
DIR_LB: IC8.13 (I1); also elsewhere on the board
DIR_RA: IC8.2 (I1); also elsewhere on the board
DIR_RB: IC8.5 (I1); also elsewhere on the board
GND: C17.2, C18.2, IC8.7 (GND), IC11.4 (V-), R27.1, R28.1; also elsewhere on the board
GND1: C13.2, C14.2, C16.2, U3.3 (AISEN), U3.6 (BISEN), U3.13 (GND), U3.17 (TH_PAD); also elsewhere on the board
MOTL_PWM: IC8.9 (I0), IC8.12 (I0), R28.2; also elsewhere on the board
MOTR_PWM: IC8.1 (I0), IC8.4 (I0), R27.2; also elsewhere on the board
unnamed: C16.1, U3.14 (VINT)
unnamed: C15.2, U3.11 (VCP)
unnamed: U3.5 (BOUT2), X4.6 (M1)
unnamed: MOT_FLT.A, R29.2
unnamed: MOT_FLT.C, U3.8 (NFAULT)
unnamed: IC8.3 (O), U3.16 (AIN1)
unnamed: IC8.6 (O), U3.15 (AIN2)
unnamed: IC8.11 (O), U3.10 (BIN2)
unnamed: IC8.8 (O), U3.9 (BIN1)
unnamed: U3.7 (BOUT1), X4.5 (M2)
unnamed: U3.4 (AOUT2), X3.5 (M2)
unnamed: U3.2 (AOUT1), X3.6 (M1)
RESET: U3.1 (NSLEEP); also elsewhere on the board
V+: C13.1, C14.1, C15.1, R29.1, U3.12 (VM); also elsewhere on the board

Notes on the sheet:
Motoren
DRV8833PWPR Motor Controller
Pololu 6V HPCB 10x12mm DC Getriebe Motor 330 rpm 1:100 I_Stall 1,5A I_free 0,1A ca. 1,5m/s

Board: 2 copper layers, 91 parts (23 on the bottom side), 71 nets, no tracks yet.

Other parts of the board:
U$1: FUTURA_V1.0_MOTOT_MOUNT
