schrmich/speedy_gonzales/Hardware/Eagle Speedy V2/LCD-Shield V2.brd

## EAGLE design Hardware/Eagle Speedy V2/LCD-Shield V2.brd (2021-03-15)

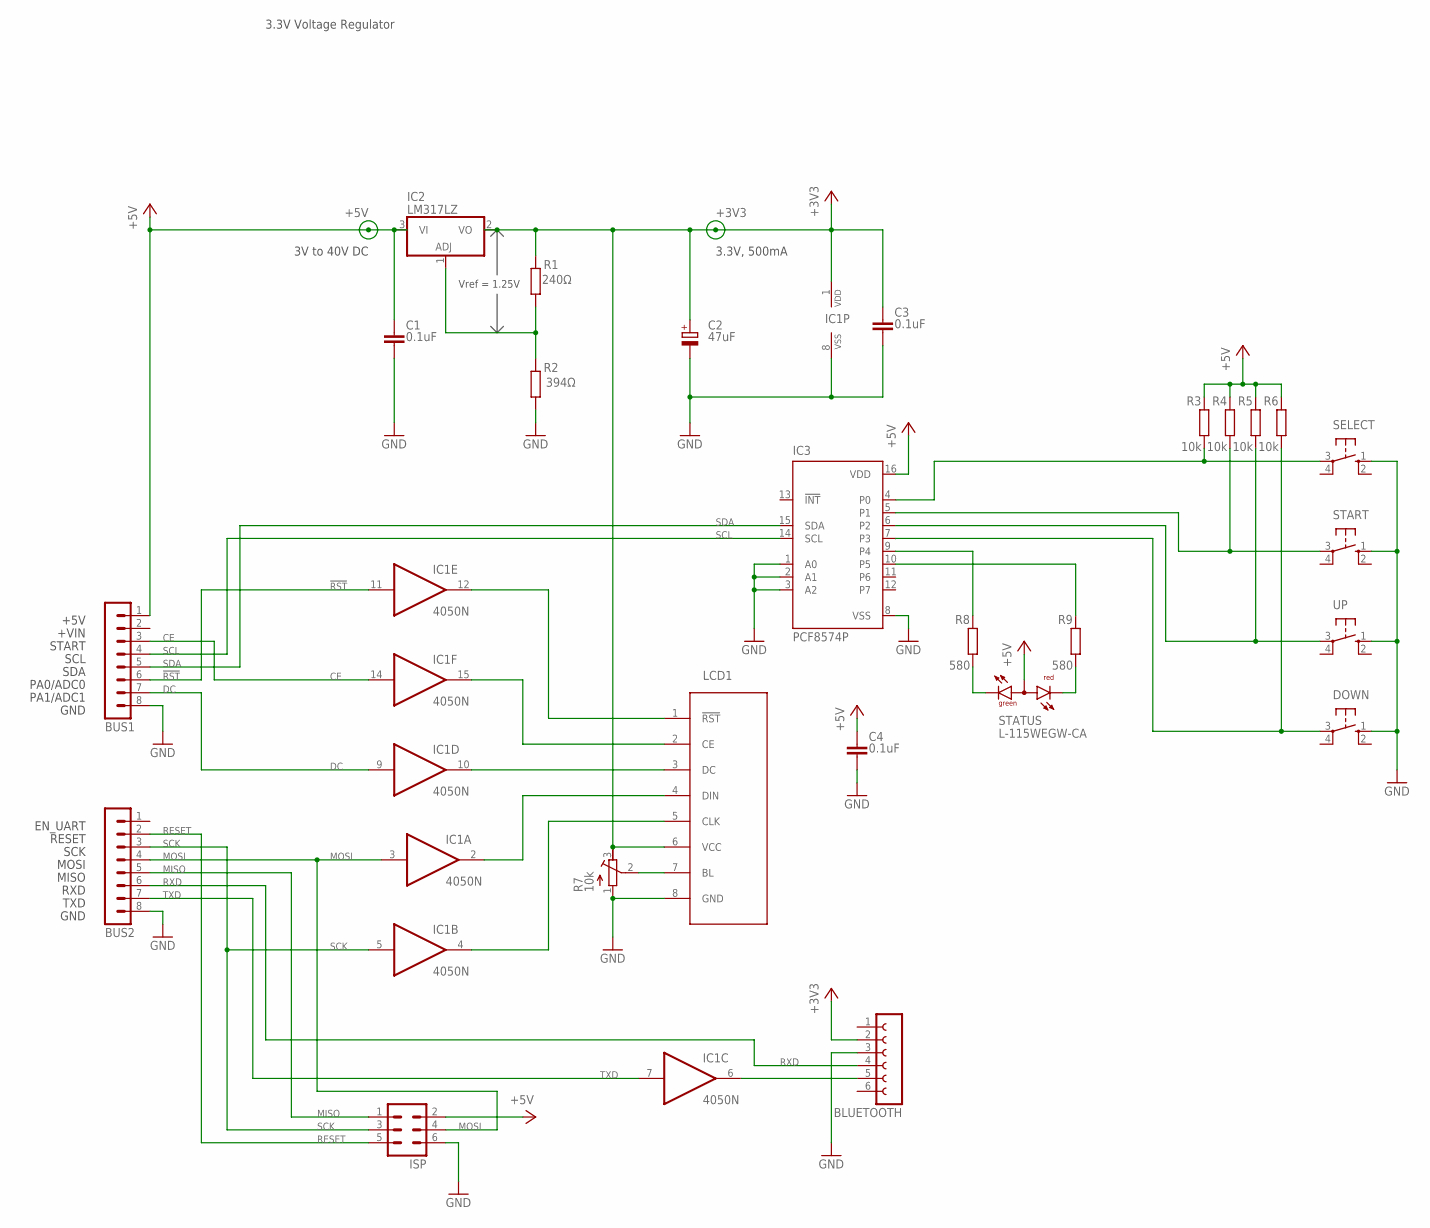
[picture p36: schematic LCD-Shield V2.sch]

Parts:
BLUETOOTH: FE06-1; FE06
BUS1, BUS2: MA08-1
C1, C3, C4: 0.1uF; C025-024X044
C2: 47uF; E2-4
DOWN: 10-XX; B3F-10XX
IC1: 4050N; DIL16
IC2: LM317LZ; TO92
IC3: PCF8574P; DIL16
ISP: MA03-2
LCD1: 5110_LCD_NOKIA; LCD_5110
R1: 240Ω; 0207/7
R2: 394Ω; 0207/7
R3, R4, R5, R6: 10k; 0207/7
R7: 10k; RTRIM3296W
R8, R9: 580; 0207/7
SELECT: 10-XX; B3F-10XX
START: 10-XX; B3F-10XX
STATUS: L-115WEGW-CA; DUOLED-A-3MM
UP: 10-XX; B3F-10XX

Connections:
!RST: BUS1.6, IC1.11 (I)
+3V3: BLUETOOTH.2, C2.+, C3.1, IC1.1 (VDD), IC2.2 (VO), LCD1.6 (VCC), R1.2, R7.3 (E)
+5V: BUS1.1, C1.1, C4.1, IC2.3 (VI), IC3.16 (VDD), ISP.2, R3.2, R4.2, R5.2, R6.2, STATUS.2 (A)
CE: BUS1.3, IC1.14 (I)
DC: BUS1.7, IC1.9 (I)
GND: BLUETOOTH.3, BUS1.8, BUS2.8, C1.2, C2.-, C3.2, C4.2, DOWN.1 (S), IC1.8 (VSS), IC3.1 (A0), IC3.2 (A1), IC3.3 (A2), IC3.8 (VSS), ISP.6, LCD1.8 (GND), R2.1, R7.1 (A), SELECT.1 (S), START.1 (S), UP.1 (S)
MISO: BUS2.5, ISP.1
MOSI: BUS2.4, IC1.3 (I), ISP.4
unnamed: IC1.12 (O), LCD1.1 (!RST)
unnamed: IC1.15 (O), LCD1.2 (CE)
unnamed: IC1.10 (O), LCD1.3 (DC)
unnamed: IC1.2 (O), LCD1.4 (DIN)
unnamed: IC1.4 (O), LCD1.5 (CLK)
unnamed: IC2.1 (ADJ), R1.1, R2.2
unnamed: R8.1, STATUS.1 (CG)
unnamed: LCD1.7 (BL), R7.2 (S)
unnamed: R9.1, STATUS.3 (CR)
unnamed: IC3.9 (P4), R8.2
unnamed: IC3.10 (P5), R9.2
unnamed: IC3.4 (P0), R3.1, SELECT.3
unnamed: IC3.5 (P1), R4.1, START.3
unnamed: IC3.6 (P2), R5.1, UP.3
unnamed: DOWN.3, IC3.7 (P3), R6.1
unnamed: BLUETOOTH.5, IC1.6 (O)
RESET: BUS2.2, ISP.5
RXD: BLUETOOTH.4, BUS2.6
SCK: BUS2.3, IC1.5 (I), ISP.3
SCL: BUS1.4, IC3.14 (SCL)
SDA: BUS1.5, IC3.15 (SDA)
TXD: BUS2.7, IC1.7 (I)

Notes on the sheet:
3.3V Voltage Regulator
3V to 40V DC
Vref = 1.25V
3.3V, 500mA
+5V
+VIN
START
SCL
SDA
PA0/ADC0
PA1/ADC1
GND
EN_UART
RESET
SCK
MOSI
MISO
RXD
TXD

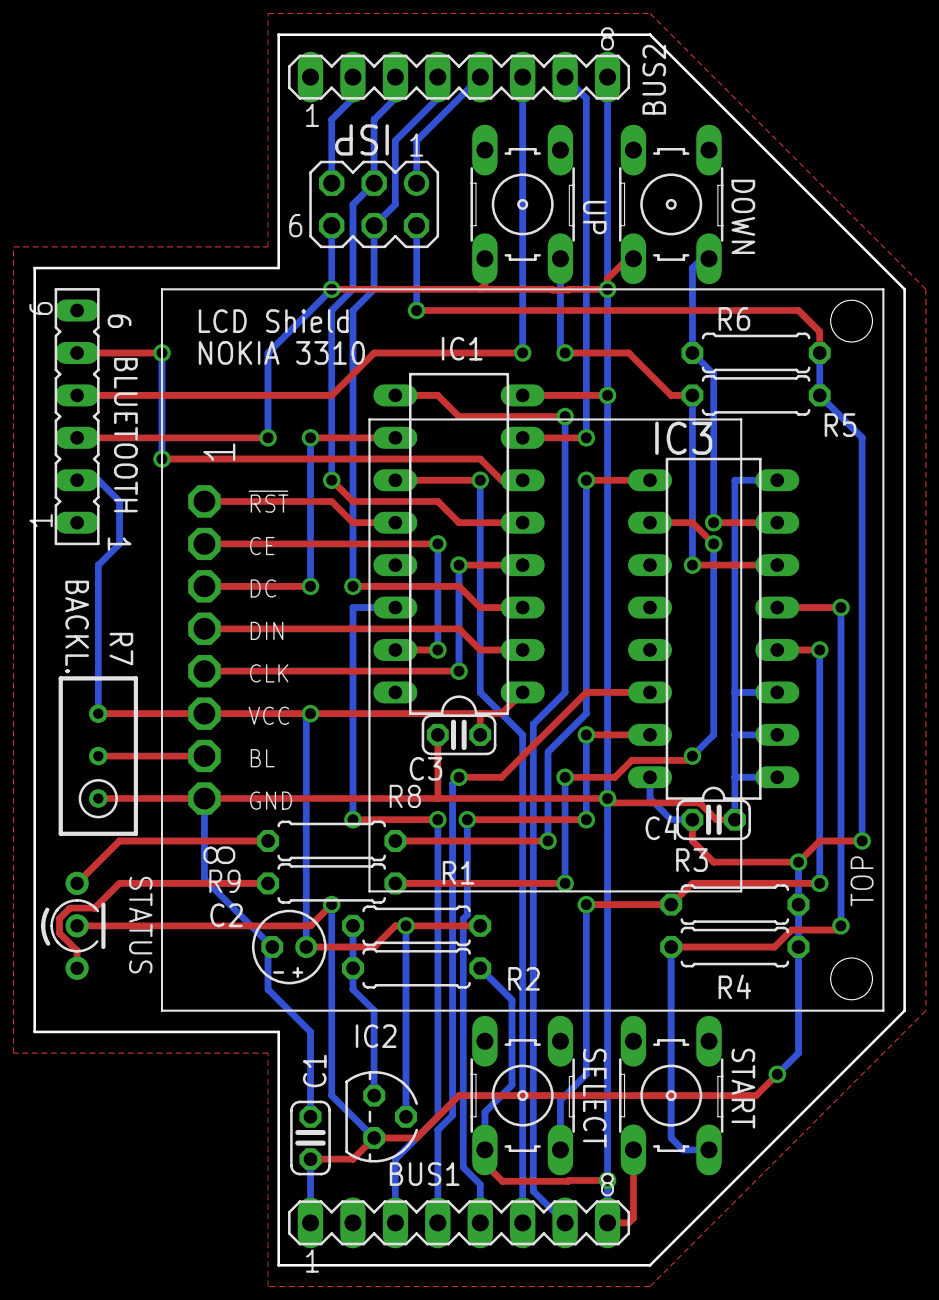
[picture p37: board LCD-Shield V2.brd from above]

Board: 2 copper layers, 52.1 x 73.7 mm, 26 parts (0 on the bottom side), 30 nets.
