schrmich/speedy_gonzales/Software/SpeedyBotV2/05 Maze Solver II/main.h

/*
 * main.h
 *
 * Created: 31.03.2020 20:25:01
 *  Author: Admin
 */ 


#ifndef MAIN_H_
#define MAIN_H_

#include <stdio.h>

//#define SIMULATOR

enum {TASK_STATE_MACHINE, TASK_SYSTEM, TASK_SIMULATOR, TASK_NUMBER};

//#define AVAILABLE_LOGGING

#define SOUND_AVAILABLE


#endif /* MAIN_H_ */
