schrmich/speedy_gonzales/Software/SpeedyBotV2/01 System/notes.c

/*
 * notes.c
 *
 * Created: 21.04.2020 16:07:52
 *  Author: mschr
 */ 

#include "notes.h"
#include <avr/pgmspace.h>

const char PROGMEM beep[6] = {
	// beep playtime:  lenght:
	//beep playtime: 0s length: 6
	0xf1,0xfa,
	0x66,0x61,0x66,0x00
};

const char PROGMEM beethoven[79] = {
	//beethoven playtime: 12s length: 79
	0xf0,0xc4,
	0x68,0x68,0x68,0x24,0x6f,0x66,0x66,0x66,
	0x23,0x6f,0x68,0x68,0x68,0x64,0x69,0x69,
	0x69,0x68,0x6e,0x14,0x6e,0x14,0x6e,0x14,
	0x2e,0x11,0x6f,0x66,0x66,0x66,0x63,0x69,
	0x69,0x69,0x68,0x6e,0x16,0x6e,0x16,0x6e,
	0x16,0x2e,0x13,0x6f,0x6e,0x18,0x6e,0x18,
	0x6e,0x16,0x2e,0x14,0x6e,0x11,0x6e,0x18,
	0x6e,0x18,0x6e,0x16,0x2e,0x14,0x6e,0x11,
	0x6e,0x18,0x6e,0x18,0x6e,0x16,0x2e,0x14,
	0x2e,0x11,0x2e,0x18,0x00
};

const char PROGMEM tetris1[57] = {
	//tetris playtime: 12s length: 57
	0xf1,0xa0,
	0x45,0x6e,0xc,0x61,0x63,0x85,0x83,0x61,
	0x6e,0xc,0x4e,0xa,0x6e,0xa,0x61,0x45,
	0x63,0x61,0x4e,0xc,0x6e,0xc,0x61,0x43,
	0x45,0x41,0x4e,0xa,0x2e,0xa,0x6f,0x43,
	0x66,0x4a,0x68,0x66,0x45,0x65,0x61,0x45,
	0x63,0x61,0x4e,0xc,0x6e,0xc,0x61,0x43,
	0x45,0x41,0x4e,0xa,0x4e,0xa,0x00
};

const char PROGMEM pacman1[59] = {
	//pacman playtime: 4s length: 59
	0xf1,0x70,
	0xae,0xc,0xaf,0xac,0xaf,0xa7,0xaf,0xa4,
	0xaf,0xac,0xa7,0x8f,0x84,0x8f,0xa1,0xaf,
	0xae,0x21,0xaf,0xa8,0xaf,0xa5,0xaf,0xae,
	0x21,0xa8,0x8f,0x85,0x8f,0xae,0xc,0xaf,
	0xac,0xaf,0xa7,0xaf,0xa4,0xaf,0xac,0xa7,
	0x8f,0x84,0x8f,0xa4,0xa5,0xa6,0xaf,0xa6,
	0xa7,0xa8,0xaf,0xa8,0xa9,0xaa,0xaf,0xbc,
	0x00
};

const char PROGMEM indiaJones[55] = {
	//IndianaJ playtime: 17s length: 55
	0xf0,0x7d,
	0x45,0x86,0x68,0x2e,0x11,0x43,0x85,0x6,
	0x48,0x8a,0x6c,0x2e,0x16,0x4a,0x8c,0x4e,
	0x11,0x4e,0x13,0x4e,0x15,0x45,0x86,0x68,
	0xe,0x11,0x4e,0x13,0x8e,0x15,0x2e,0x16,
	0x48,0x88,0x4e,0x15,0x4e,0x13,0x88,0x4e,
	0x15,0x4e,0x13,0x88,0x4e,0x16,0x4e,0x15,
	0x8e,0x13,0x2e,0x11,0x00
};

const char PROGMEM mario[128] = {
	//smb playtime: 20s length: 128
	0xf1,0x64,
	0x85,0x85,0xaf,0x65,0x81,0x65,0x68,0x6f,
	0x6e,0x8,0x6f,0x61,0x8f,0x6e,0x8,0x8f,
	0x6e,0x5,0x8f,0x6e,0xa,0x6e,0xc,0x8e,
	0xb,0x6e,0xa,0x9e,0x8,0x85,0x88,0x6a,
	0x86,0x68,0x65,0x81,0x83,0x6e,0xc,0x8f,
	0x61,0x8f,0x6e,0x8,0x8f,0x6e,0x5,0x8f,
	0x6e,0xa,0x6e,0xc,0x8e,0xb,0x6e,0xa,
	0x9e,0x8,0x85,0x88,0x6a,0x86,0x68,0x65,
	0x81,0x83,0x6e,0xc,0x6f,0x88,0x87,0x86,
	0x84,0x8f,0x85,0x8f,0x8e,0x9,0x8e,0xa,
	0x81,0x8f,0x8e,0xa,0x81,0x83,0x6f,0x88,
	0x87,0x86,0x84,0x8f,0x85,0x8f,0x8e,0x21,
	0x8f,0x8e,0x21,0x8e,0x21,0x4f,0x88,0x87,
	0x86,0x84,0x8f,0x85,0x8f,0x8e,0x9,0x8e,
	0xa,0x81,0x8f,0x8e,0xa,0x81,0x83,0x6f,
	0x84,0x6f,0x83,0x6f,0x81,0x00
};

const char PROGMEM knightraider[23] = {
	//KnightRider playtime: 4s length: 23
	0xf0,0x3f,
	0x85,0xa6,0xa5,0x6c,0x8e,0x15,0xae,0x16,
	0xae,0x15,0x6c,0x85,0xa6,0xa5,0x8c,0x8e,
	0x15,0x4e,0x13,0x6f,0x00
};

const char PROGMEM monkey_theme[54] = {
//misland playtime: 11s length: 54
0xf1,0xb4,
0x65,0x6f,0x65,0x68,0x67,0x65,0x43,0x25,
0x6f,0x63,0x6f,0x63,0x61,0x6e,0xc,0x63,
0x61,0x6f,0x61,0x6f,0x4e,0xc,0x4f,0x65,
0x6f,0x55,0x68,0x67,0x65,0x43,0x25,0x6f,
0x67,0x68,0x6f,0x68,0x6f,0x4a,0x4f,0x47,
0x6f,0x68,0x67,0x65,0x63,0x67,0x68,0x6f,
0x68,0x6f,0x47,0x00
};
