schrmich/speedy_gonzales/Software/Speedy Project/BaseLib/globals.h

/*
 * globals.h
 *
 * Created: 27.12.2020 15:02:04
 *  Author: mschr
 */ 


#ifndef GLOBALS_H_
#define GLOBALS_H_

#include "speedy.h"
#include "system.h"

extern Motor motor;
extern Scheduler51 scheduler;
extern BaseSystem baseSystem;


#endif /* GLOBALS_H_ */
