schrmich/speedy_gonzales/Software/SpeedyBotV2/01 System/notes.h

/*
 * notes.h
 *
 * Created: 21.04.2020 14:07:57
 *  Author: mschr
 */ 


#ifndef NOTES_H_
#define NOTES_H_

#include <avr/pgmspace.h>

extern const char PROGMEM beep[];

extern const char PROGMEM beethoven[];

extern const char PROGMEM tetris1[];

extern const char PROGMEM pacman1[];

extern const char PROGMEM indiaJones[];

extern const char PROGMEM mario[];

extern const char PROGMEM knightraider[];

extern const char PROGMEM monkey_theme[];

#endif /* NOTES_H_ */
