schrmich/speedy_gonzales/Software/SpeedyBotV2/01 System/testfunctions.h

/*
 * testfunctions.h
 *
 * Created: 31.03.2020 16:26:47
 *  Author: mschr
 */ 


#ifndef TESTFUNCTIONS_H_
#define TESTFUNCTIONS_H_

void parserDistance(void);
void testDistance(void);
//void testSound(void);


#endif /* TESTFUNCTIONS_H_ */
