schrmich/speedy_gonzales/Software/SpeedyBotV2/LCD Shield/line_follower/line_menu.h

/*
 * menu.h
 *
 * Created: 24.01.2021 21:13:06
 *  Author: mschr
 */ 


#ifndef LINE_MENU_H_
#define LINE_MENU_H_

void task_pid_line_menu_render(void);

void task_pid_line_keyHandler(void);

#endif /* LINE_MENU_H_ */
