schrmich/speedy_gonzales/Software/SpeedyBotV2/LCD Shield/menu.h

/*
 * menu.h
 *
 * Created: 24.01.2021 21:13:06
 *  Author: mschr
 */ 


#ifndef MENU_H_
#define MENU_H_

void main_menu_render(void);

void main_menu_key_update(void);

void menu_scheduler_restore(void);

void menu_scheduler_emty(void);

#endif /* MENU_H_ */
