schrmich/speedy_gonzales/Software/SpeedyBotV2/LCD Shield/remote/menu_rem.h

/*
 * menu.h
 *
 * Created: 24.01.2021 21:13:06
 *  Author: mschr
 */ 


#ifndef REM_MENU_H_
#define REM_MENU_H_

void rem_menu_render(void);

void rem_menu_key_update(void);


#endif /* REM_MENU_H_ */
