schrmich/speedy_gonzales/(notices)

Notices in the files:
Software/SpeedyBotV2/07 LCD Test/nokia5110.h:
modify it under the terms of the GNU General Public Licence
